kia-8/SPRO2_S.O.B/README.md

# SPRO2_S.O.B
This repository is the Solar Optimizing Blossom (S.O.B.) which is a flower-shaped, self sustaining security device. It uses dual-axis solar-tracking petals to maximize energy collection and powers a motion activated audio alarm.
