kia-8/SPRO2_S.O.B/Mechanical/Technical Drawing/kiarash_Assembly SOB final.pdf

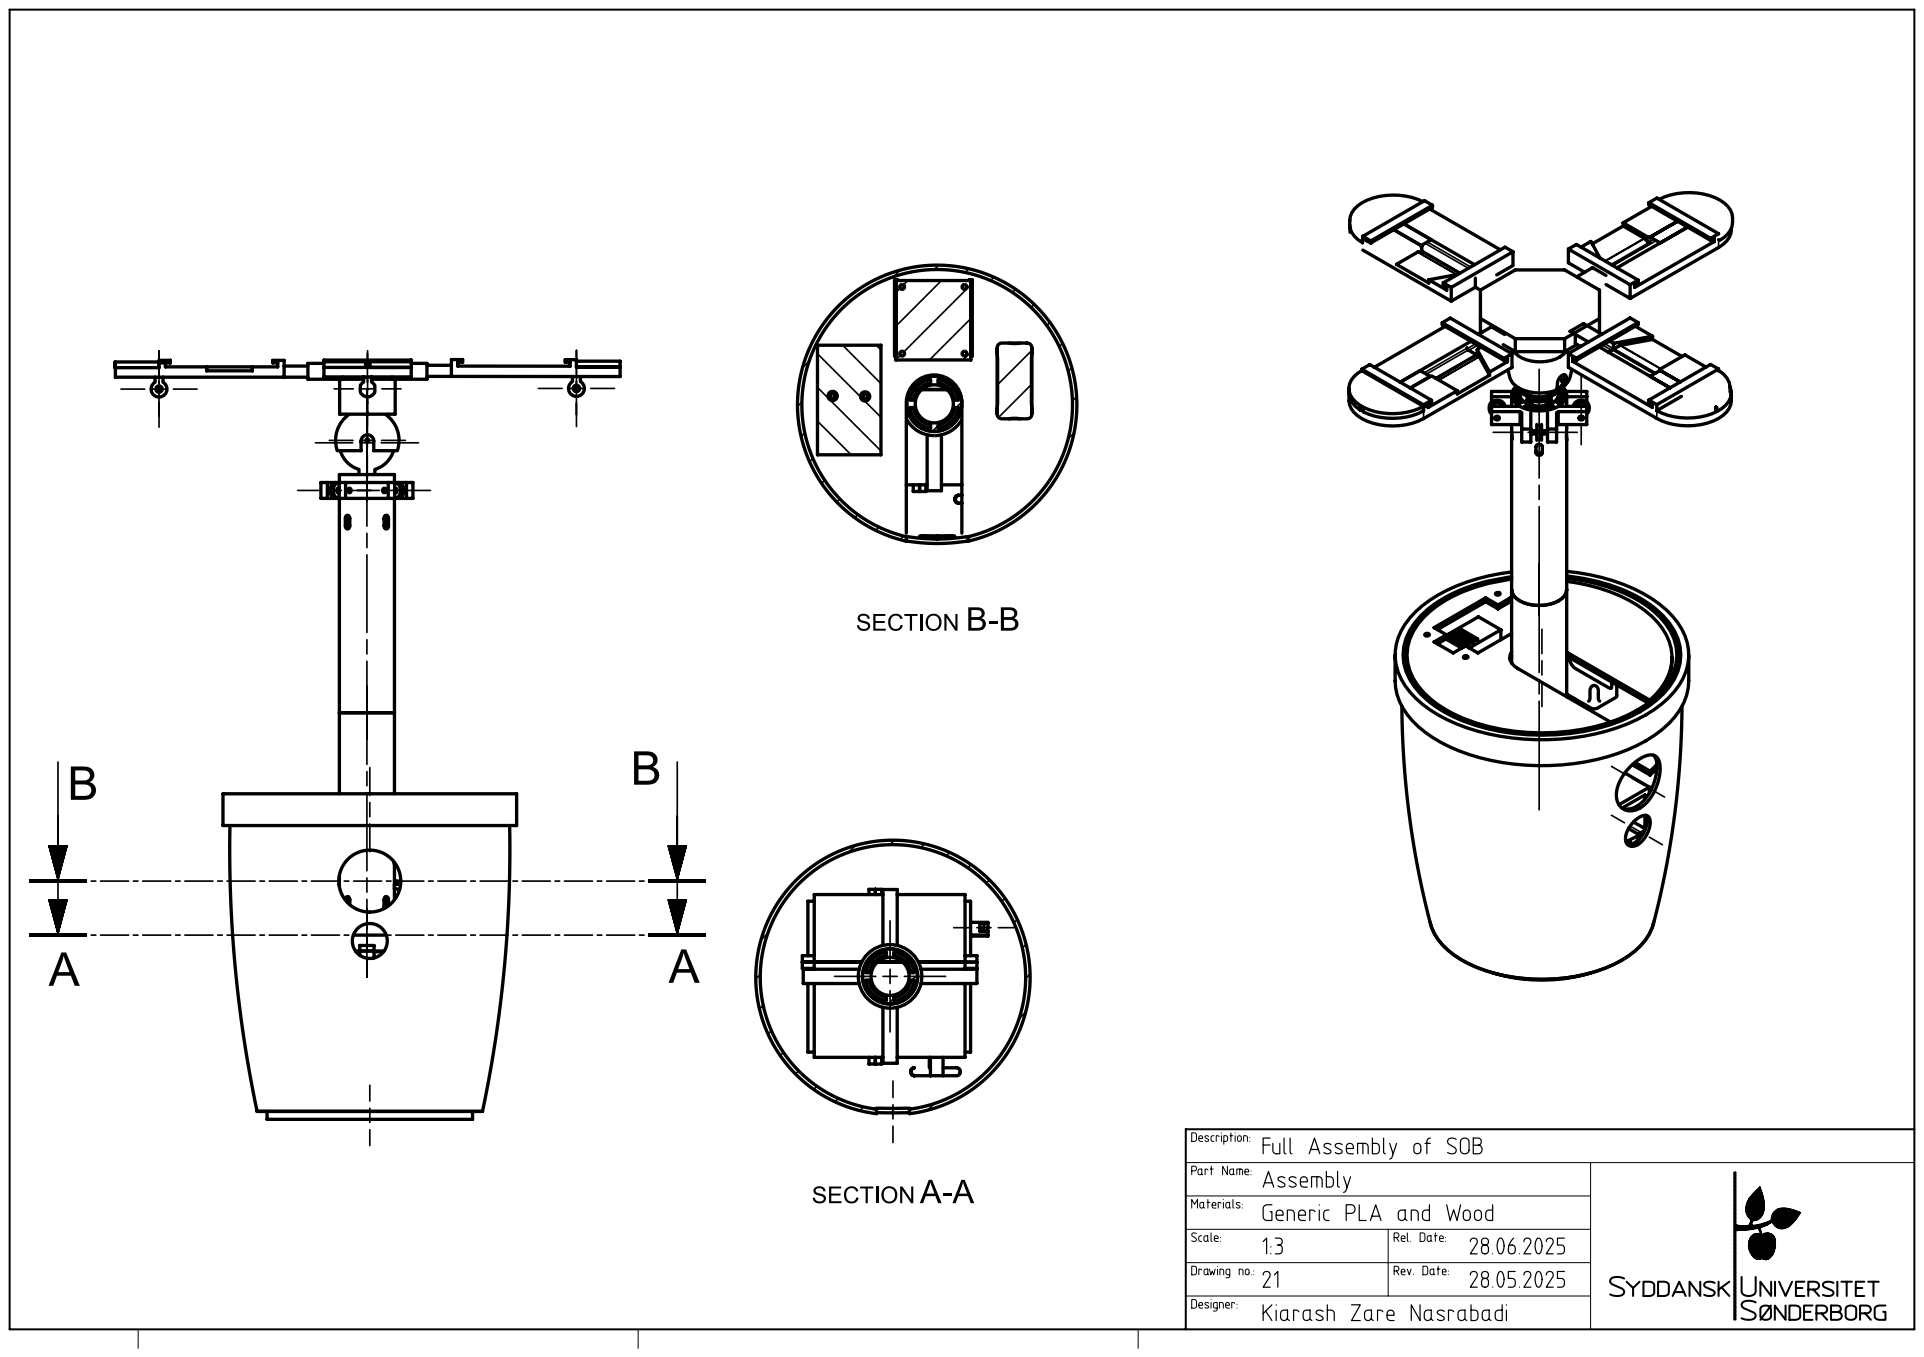
[picture p84: page 1]
