kia-8/SPRO2_S.O.B/Mechanical/Technical Drawing/kiarash_Battery holder.pdf

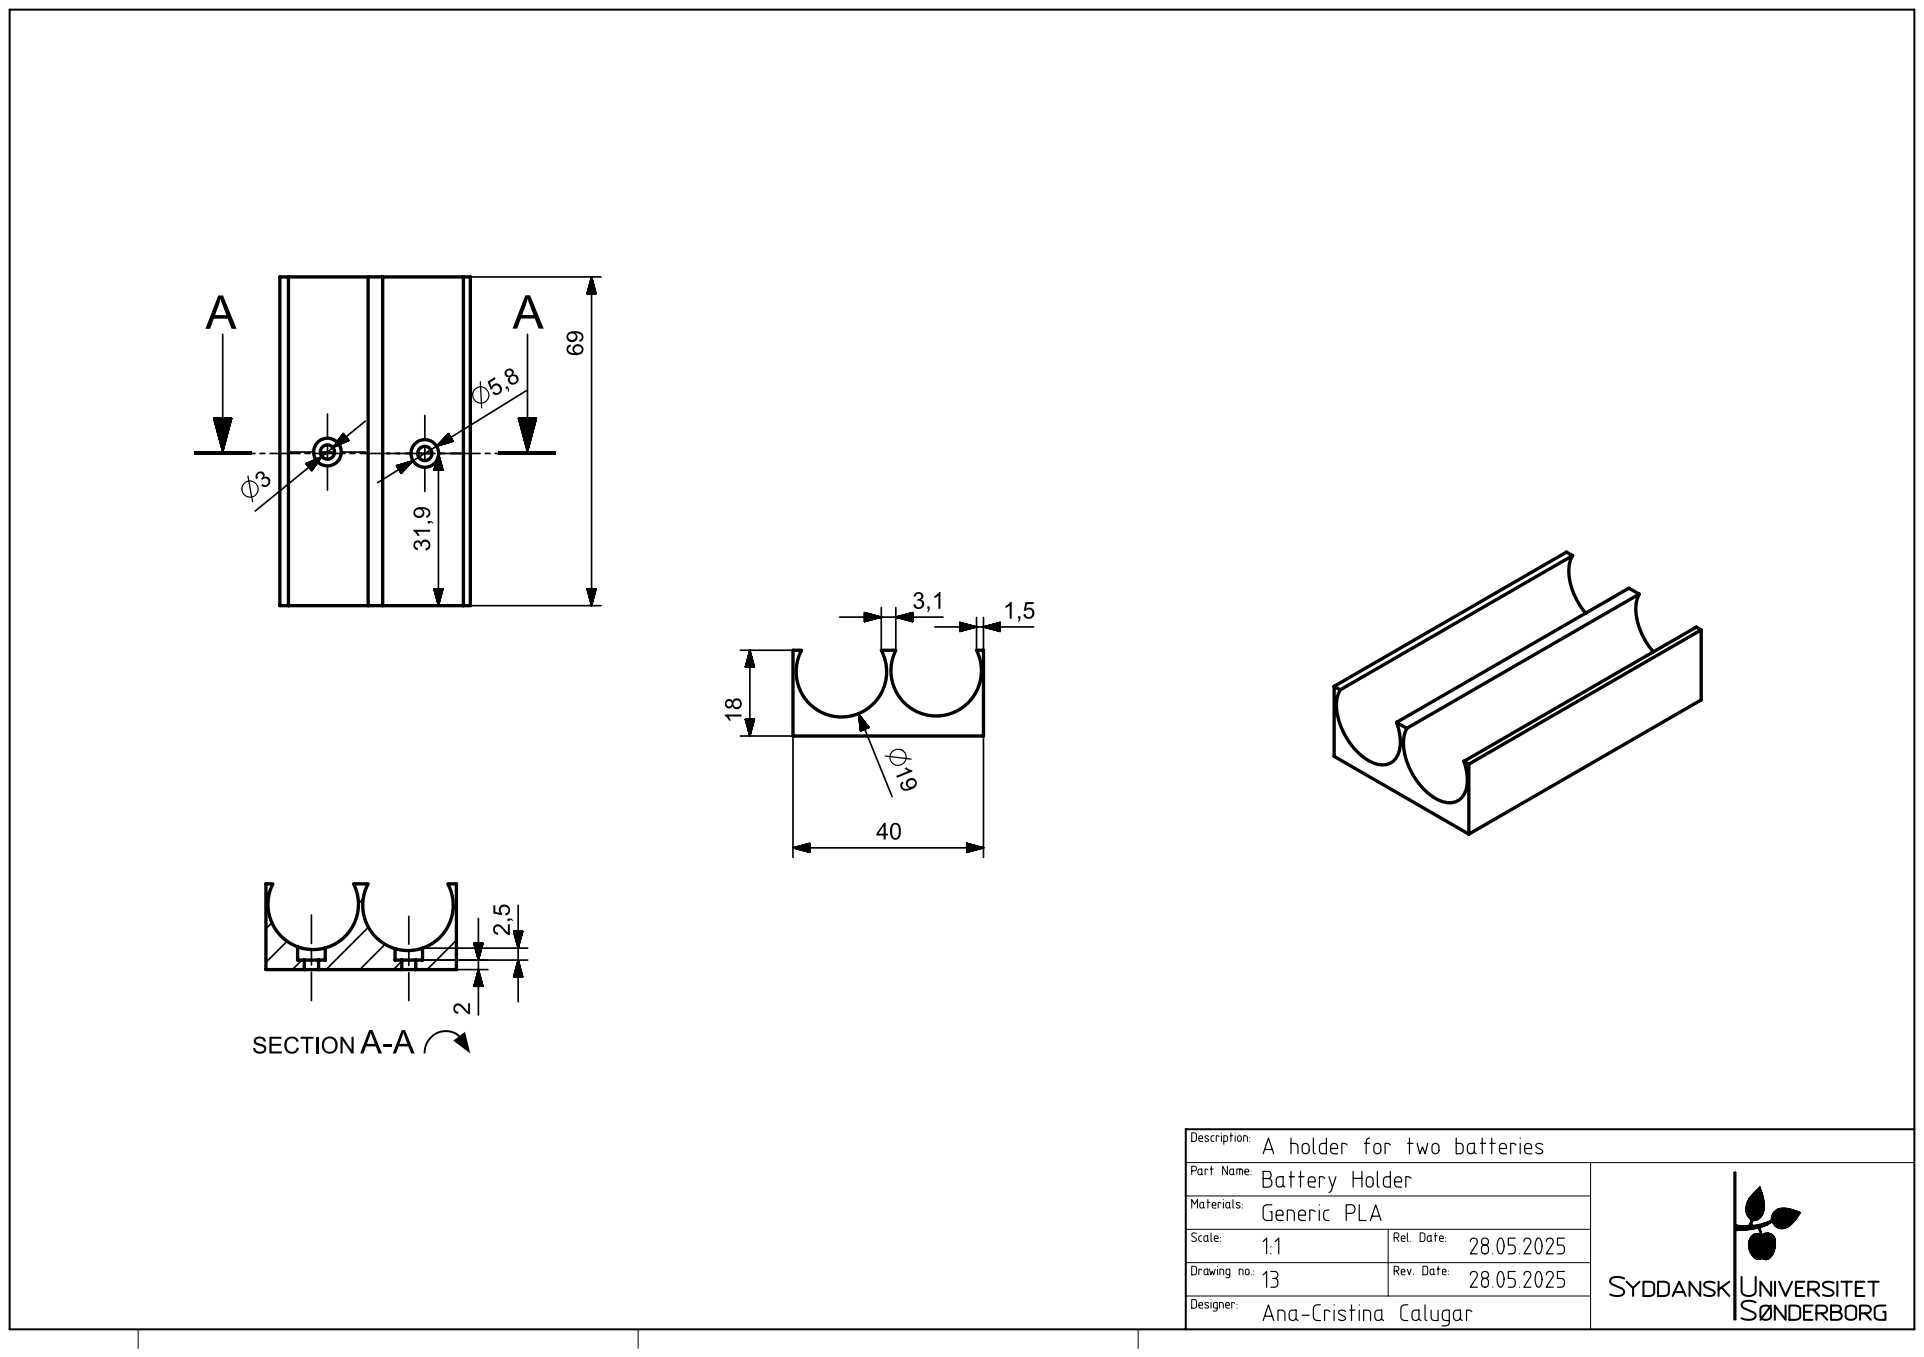
[picture p85: page 1]
