kia-8/SPRO2_S.O.B/Mechanical/Technical Drawing/kiarash_batteryholder2.pdf

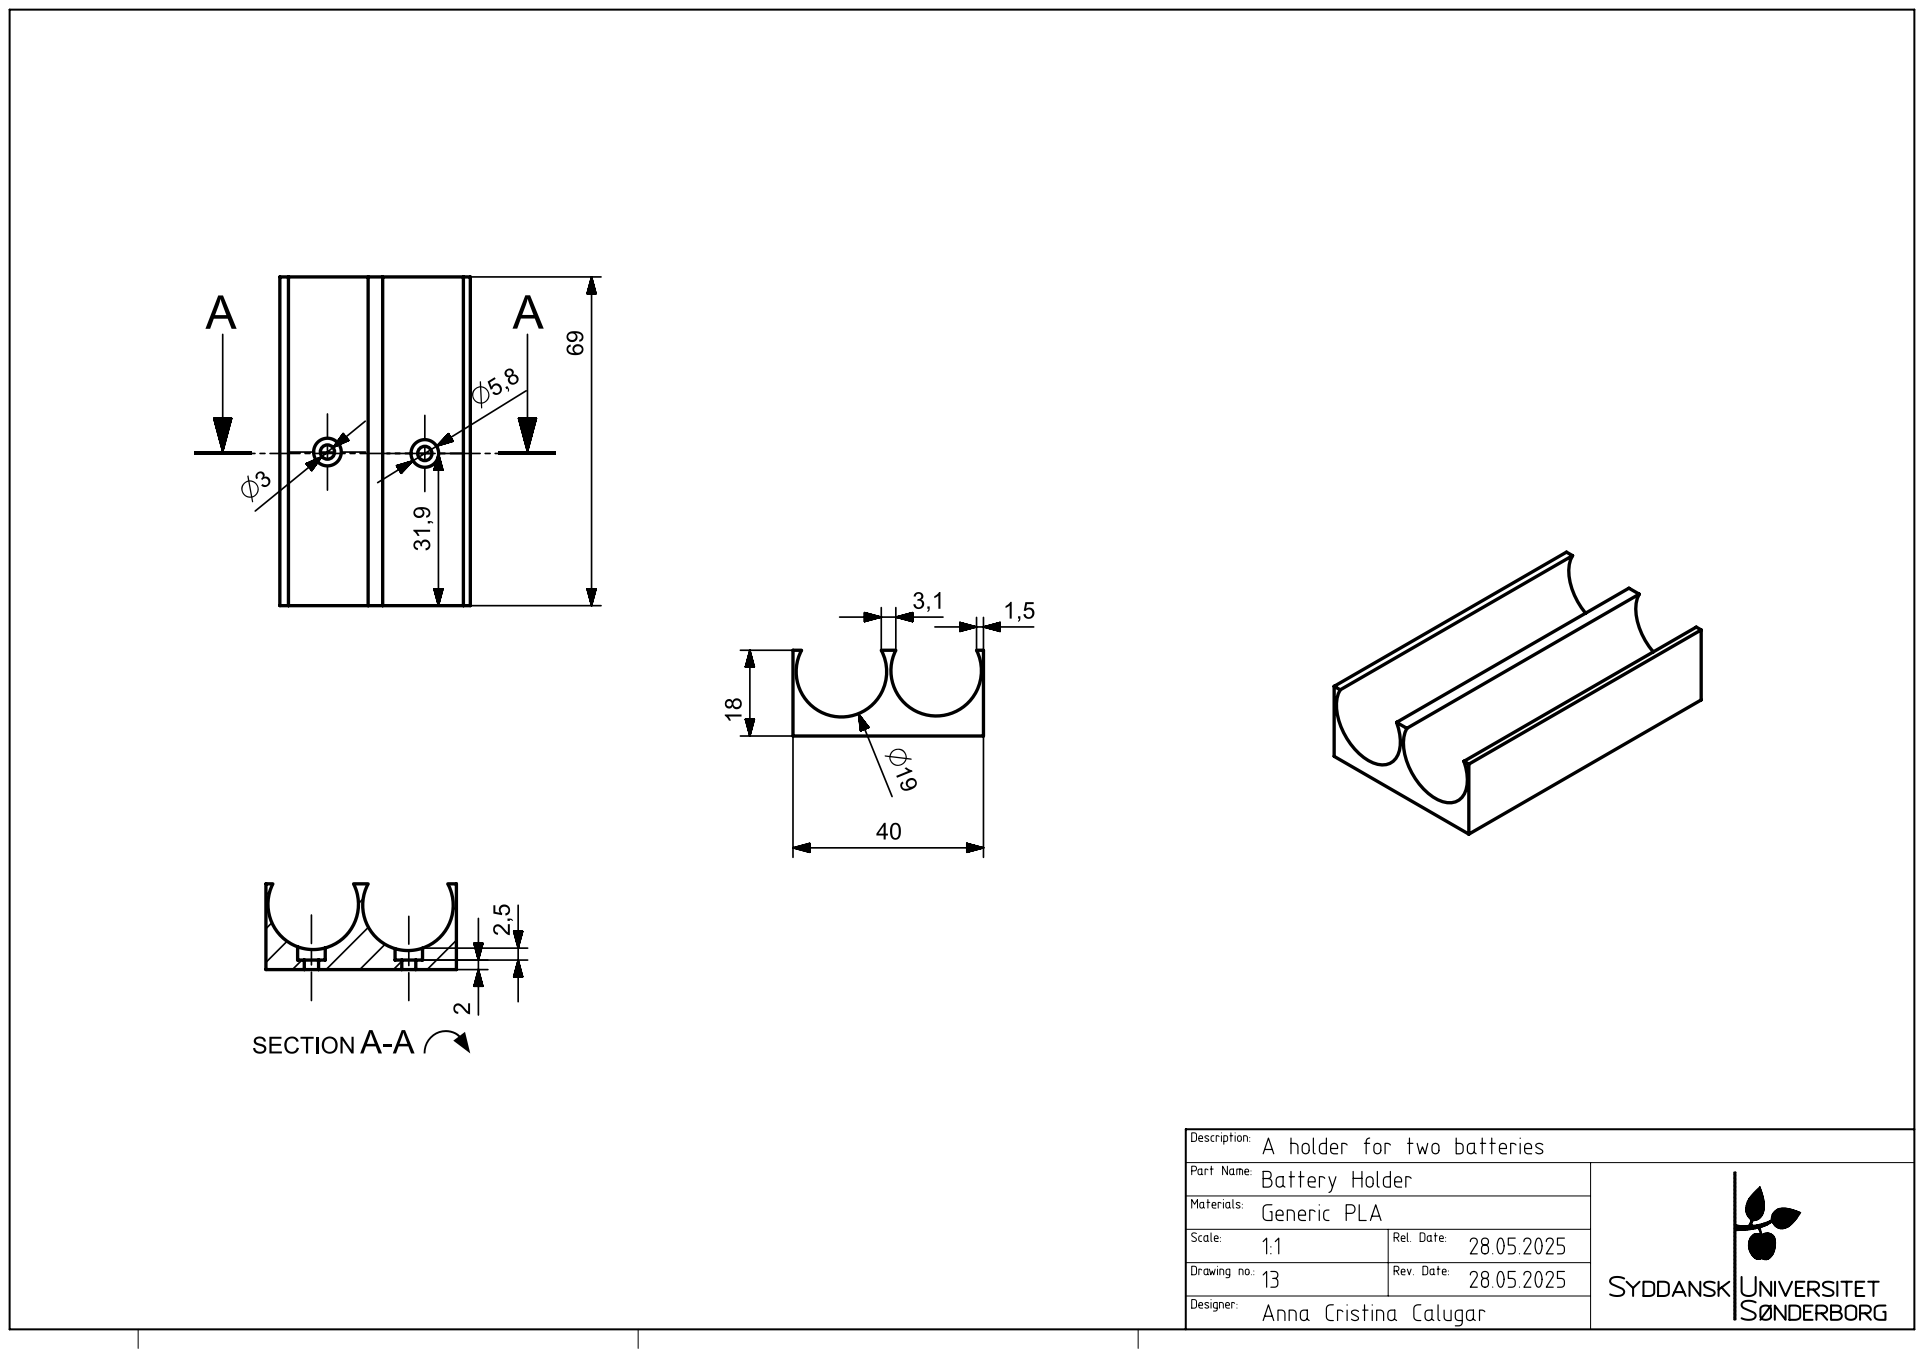
[picture p86: page 1]
