kia-8/SPRO2_S.O.B/Mechanical/Technical Drawing/kiarash_Cap of case for servo2.pdf

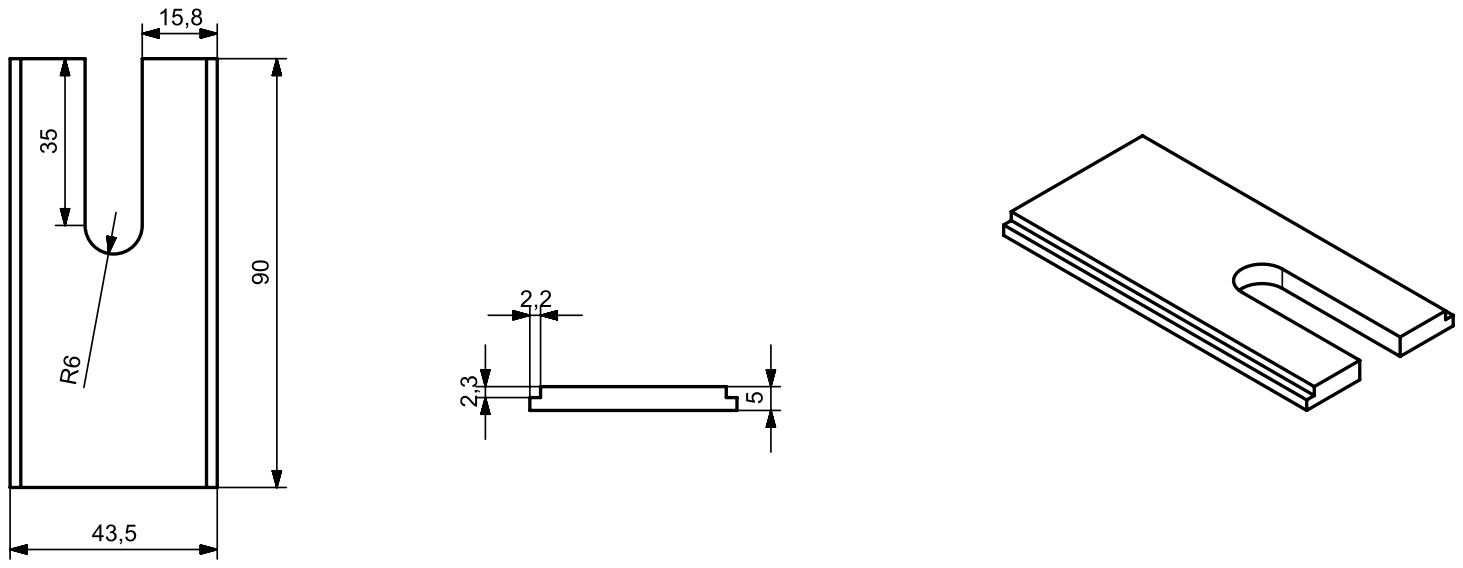
[picture p87: page 1]
