kia-8/SPRO2_S.O.B/Mechanical/Technical Drawing/kiarash_case for motor driver 2.2.pdf

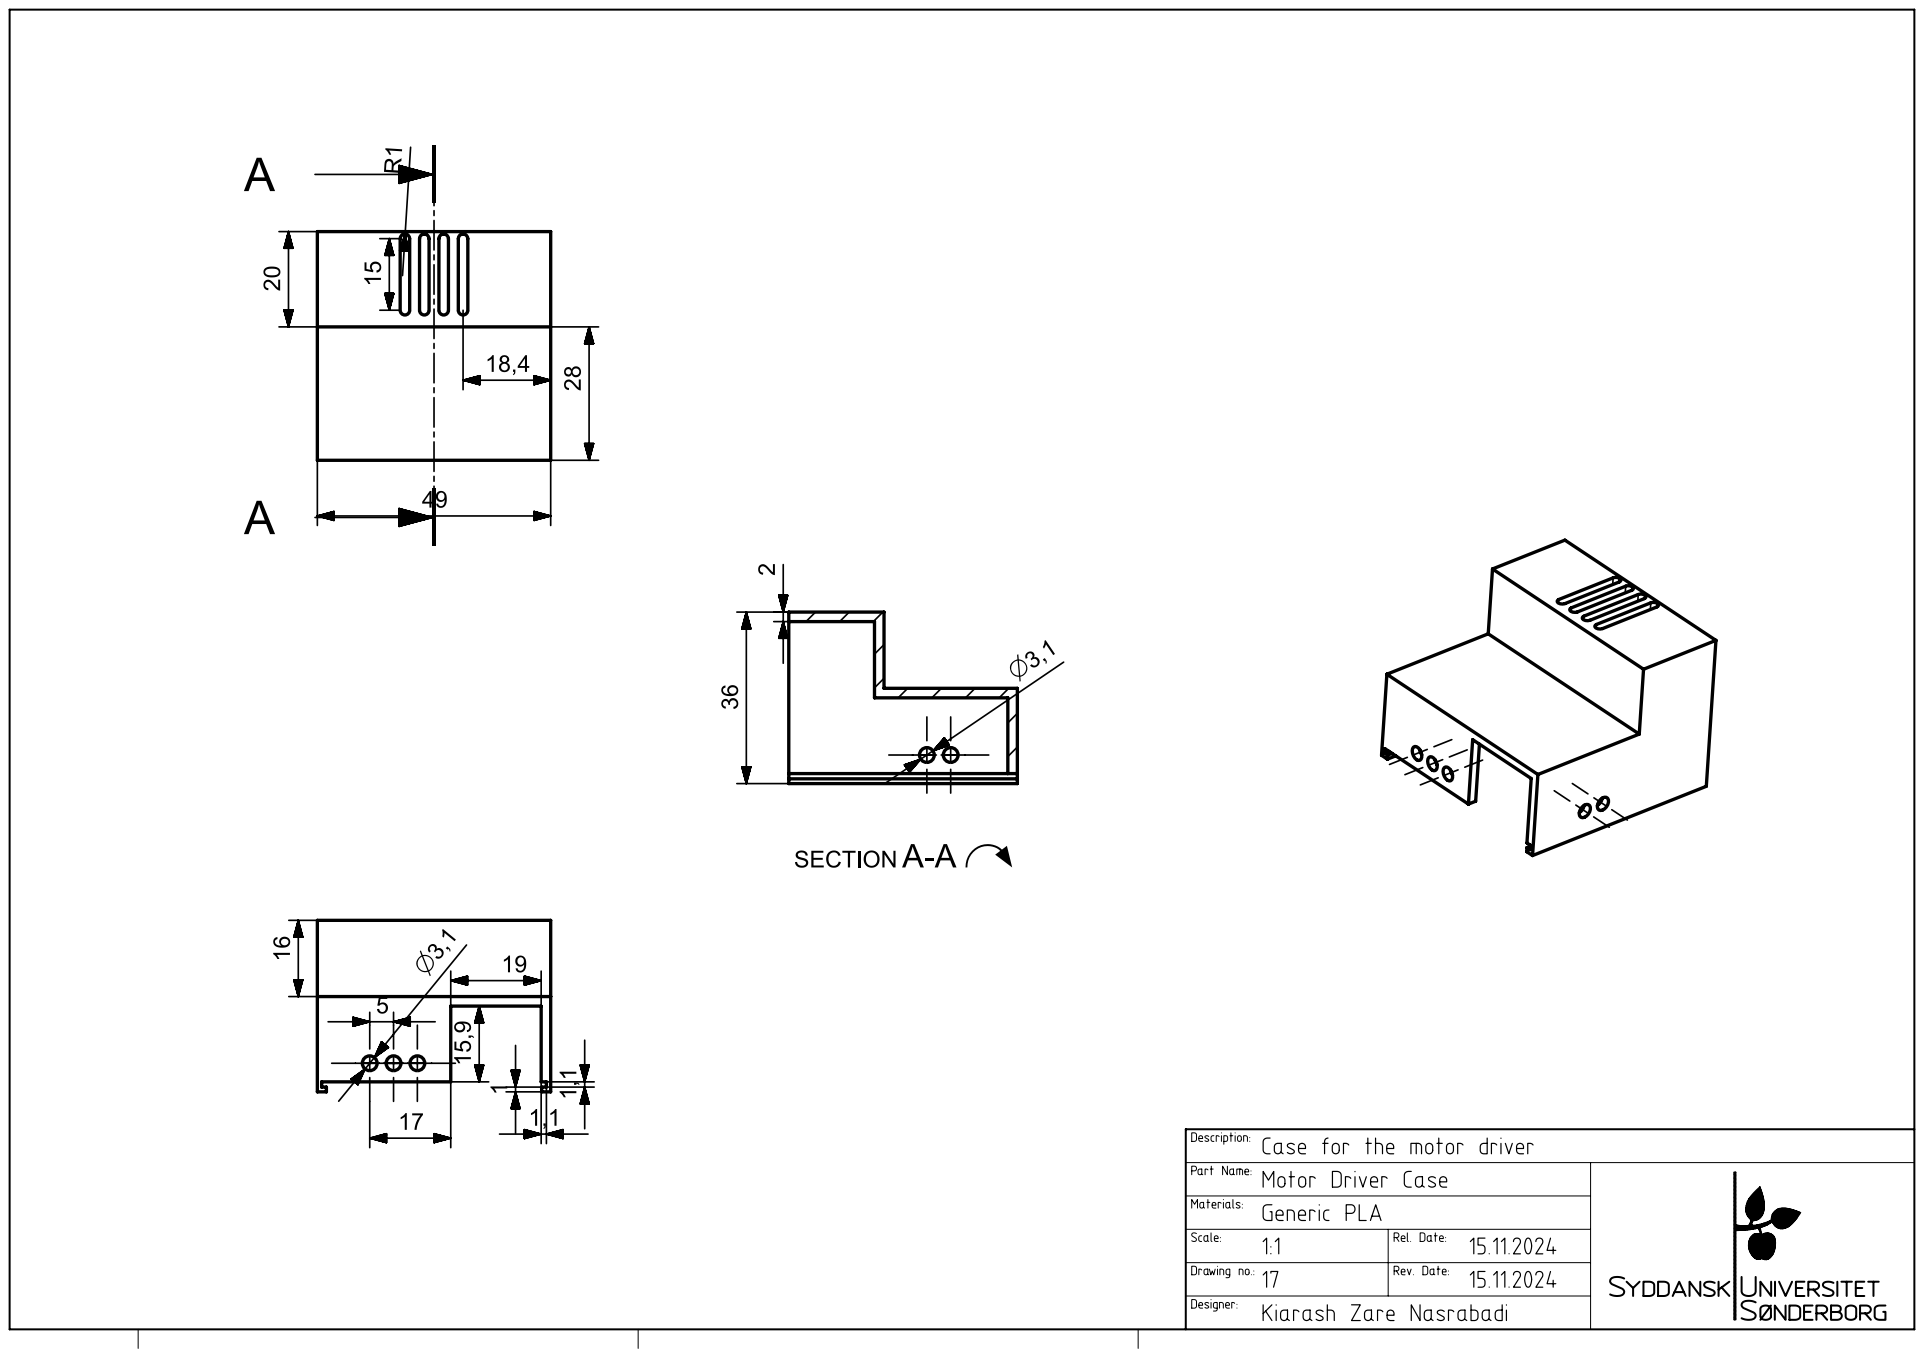
[picture p88: page 1]
