kia-8/SPRO2_S.O.B/Mechanical/Technical Drawing/kiarash_Case toop part final.pdf

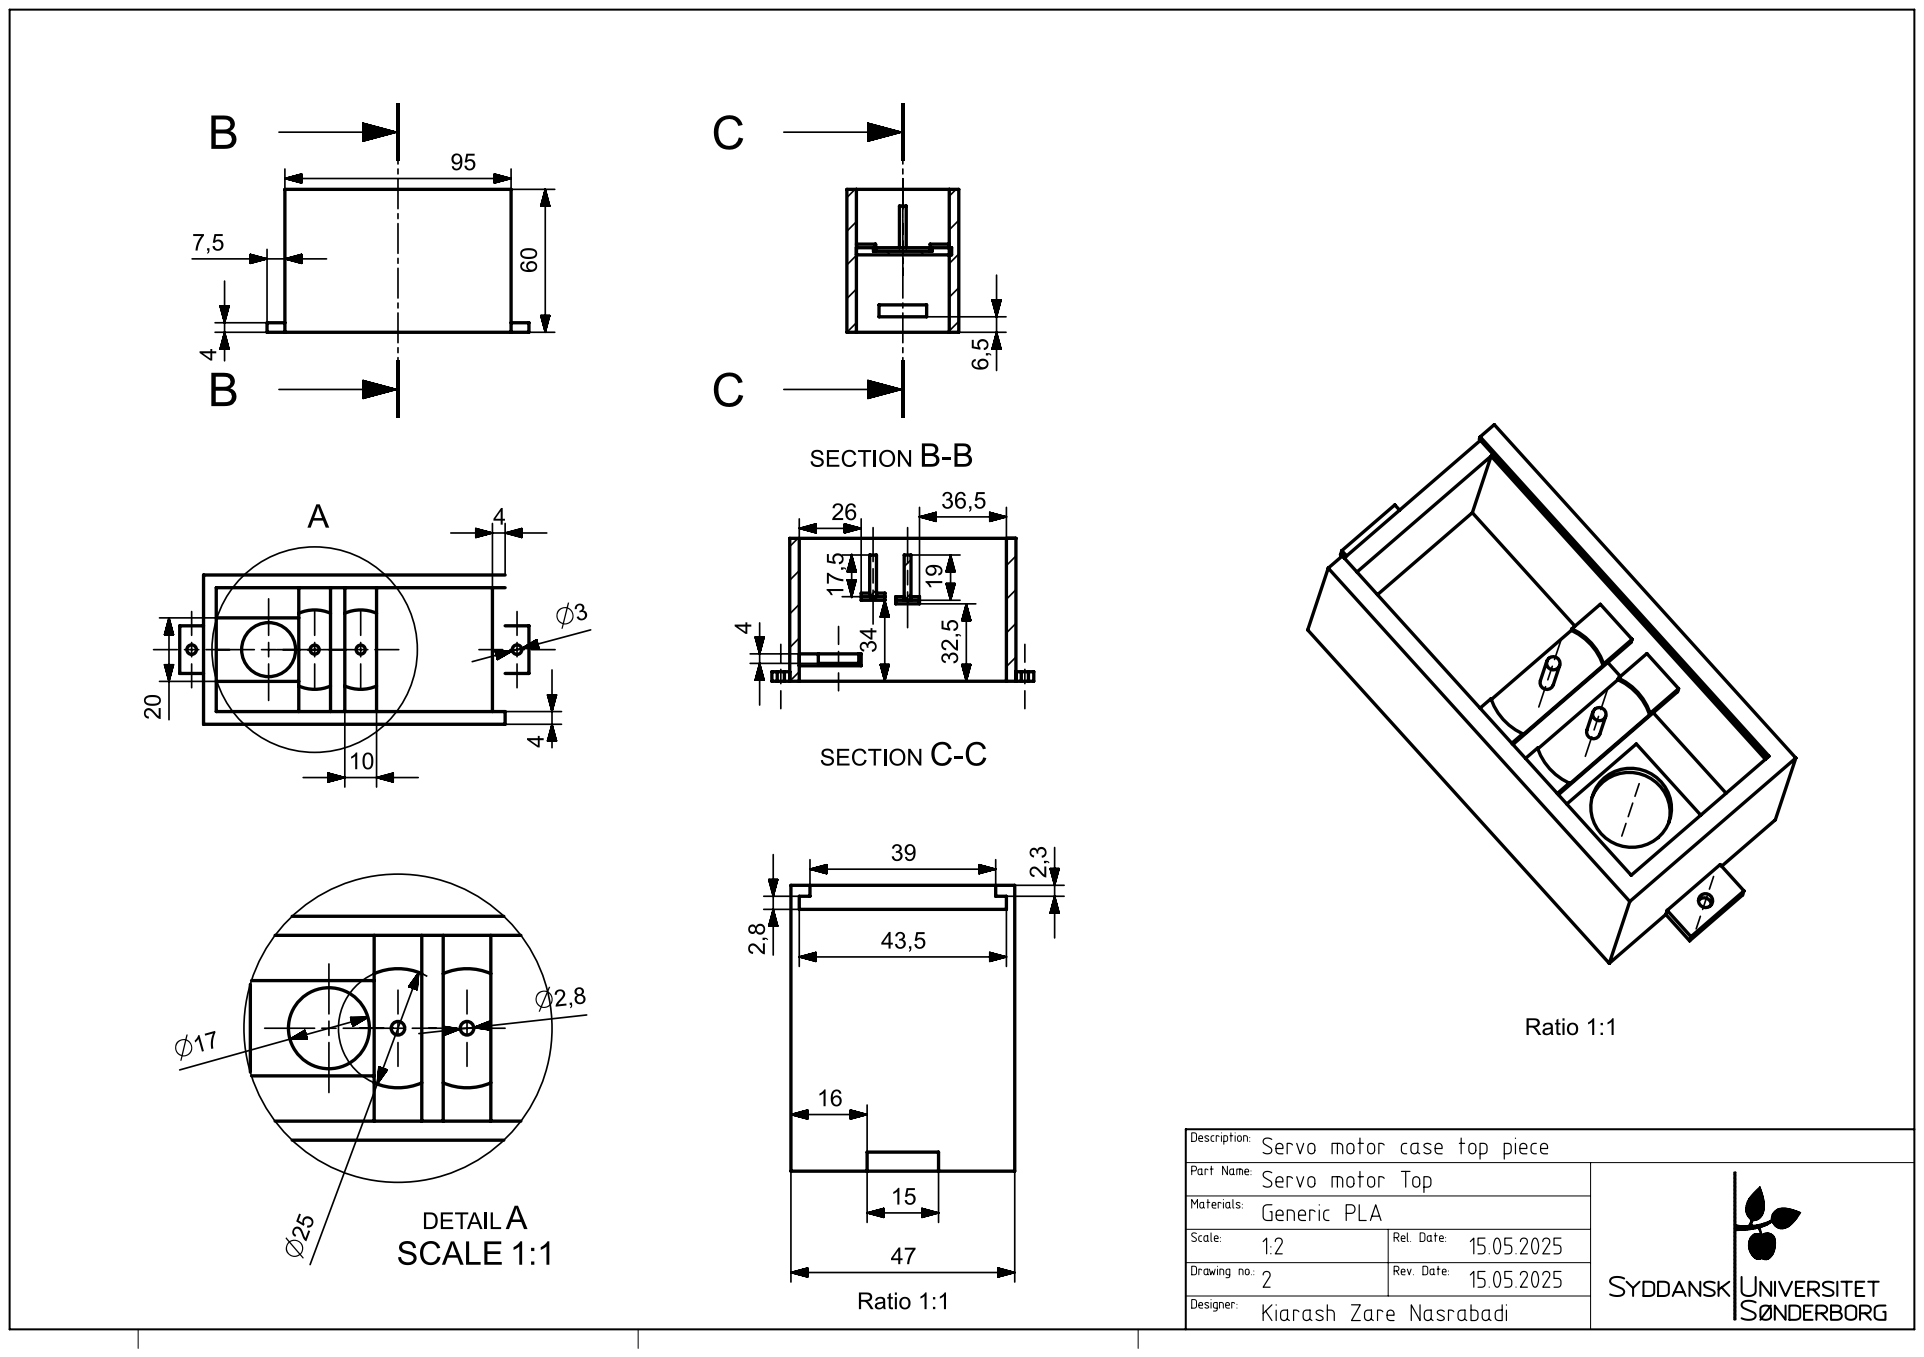
[picture p89: page 1]
