kia-8/SPRO2_S.O.B/Mechanical/Technical Drawing/kiarash_Case top part final.pdf

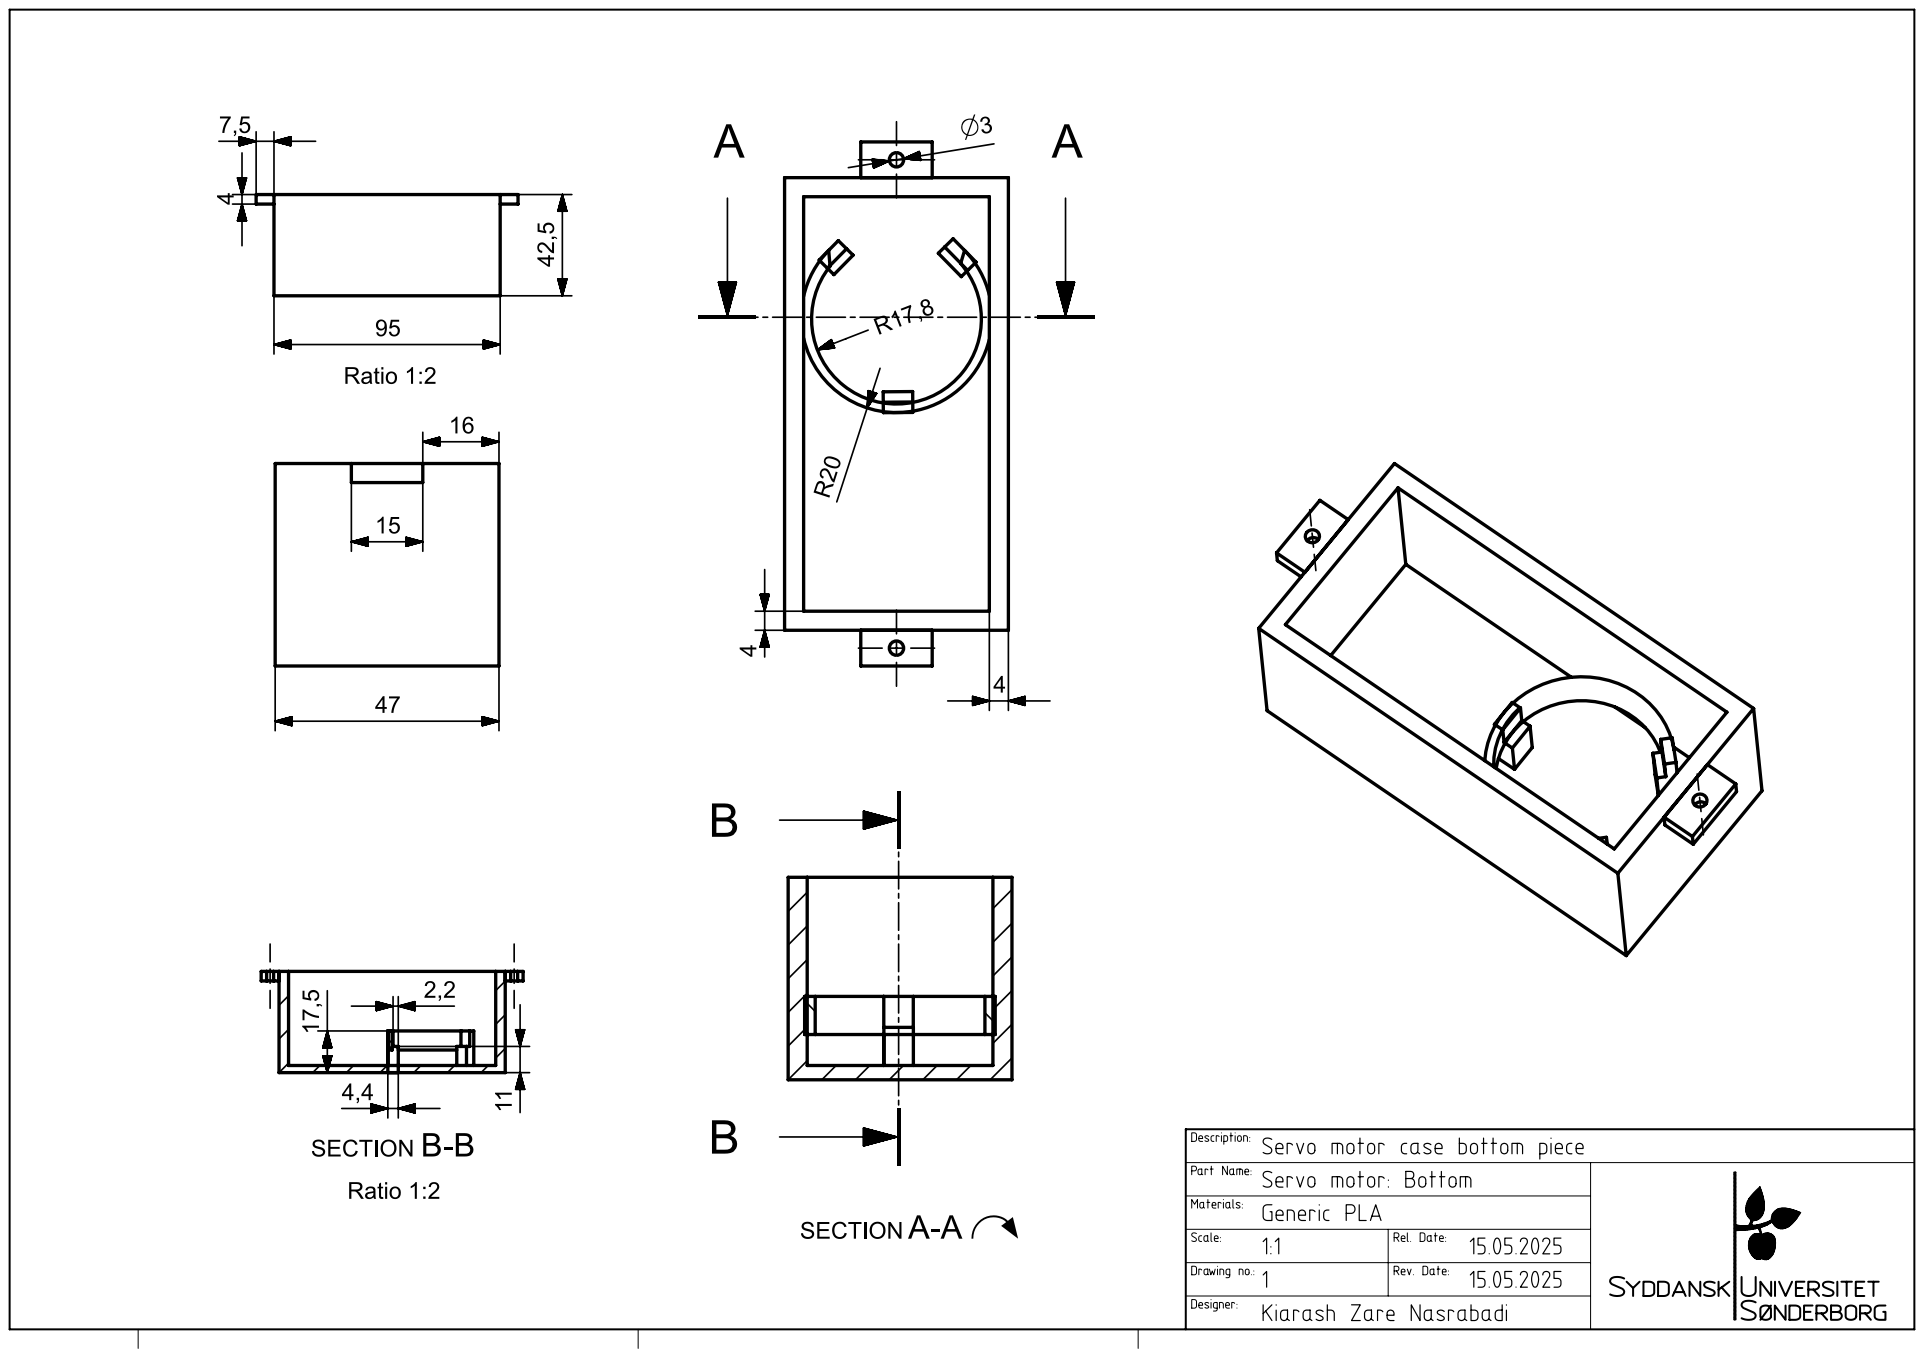
[picture p90: page 1]
