kia-8/SPRO2_S.O.B/Mechanical/Technical Drawing/kiarash_Exploded View SOBl.pdf

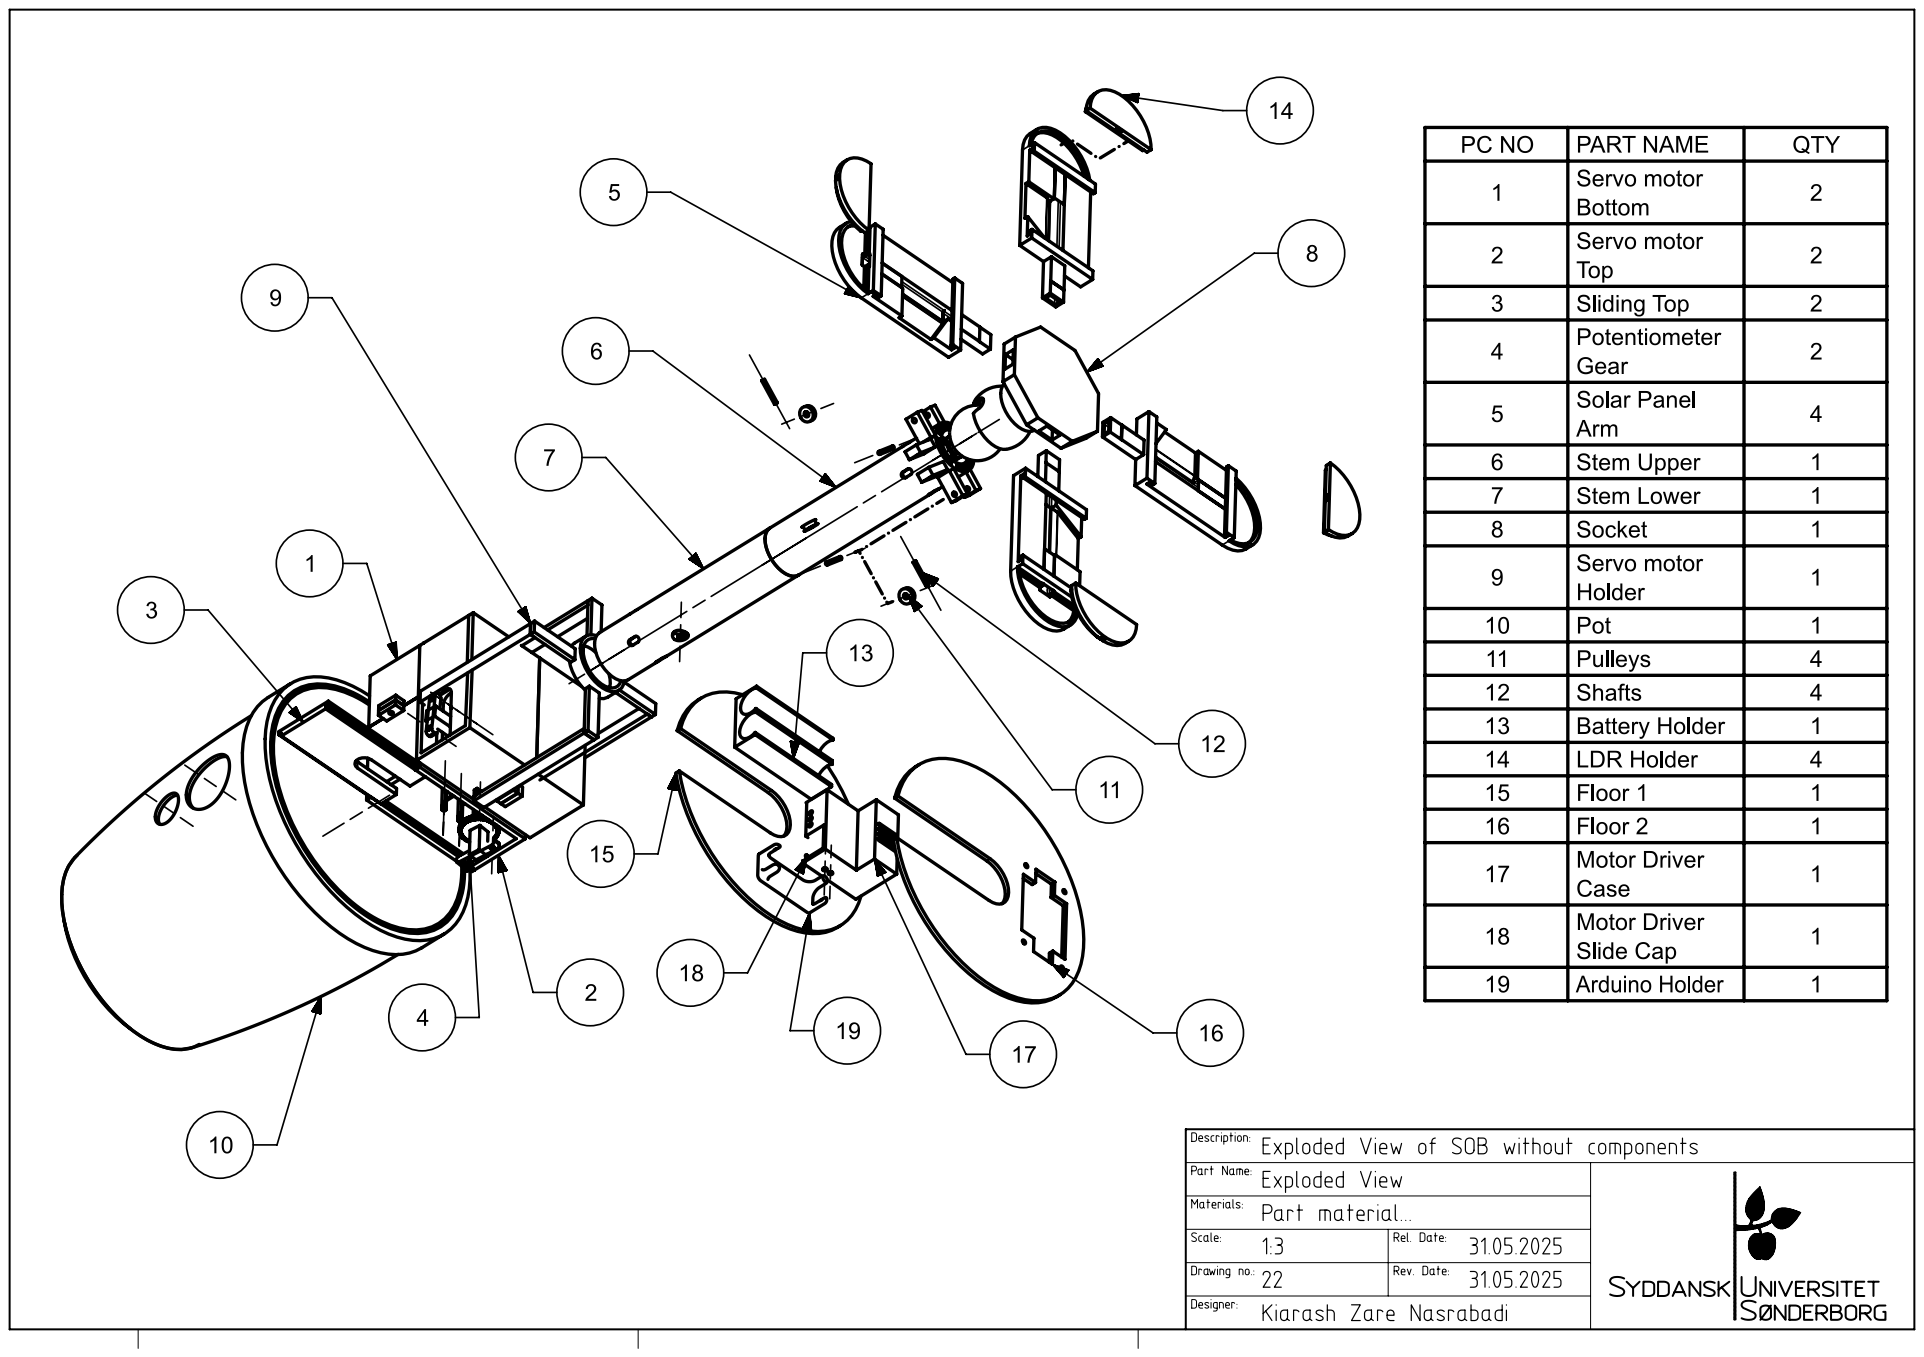
[picture p91: page 1]
