kia-8/SPRO2_S.O.B/Mechanical/Technical Drawing/kiarash_Exploded View.pdf

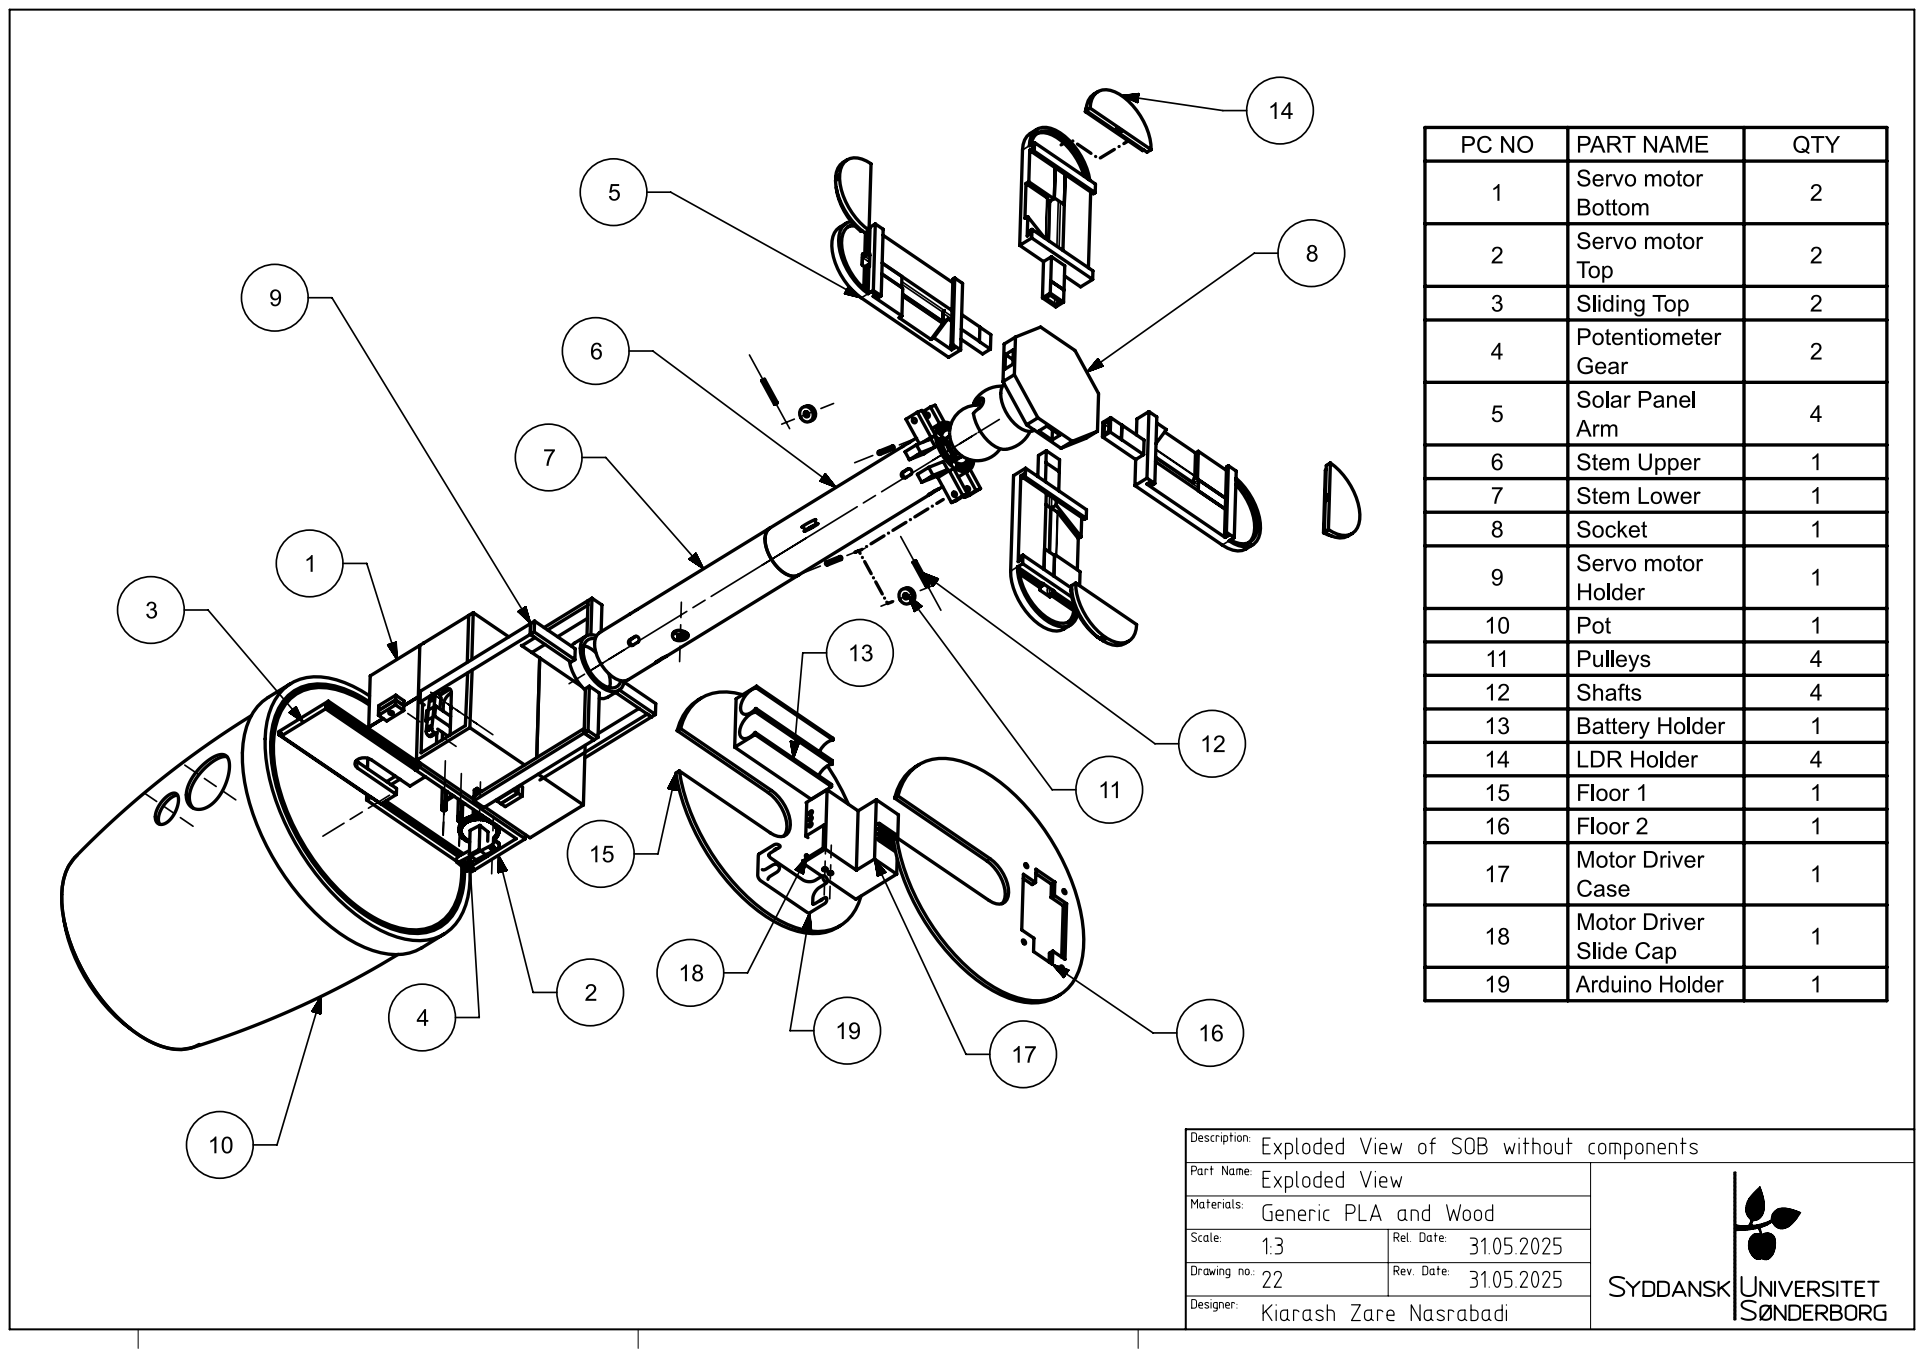
[picture p92: page 1]
