kia-8/SPRO2_S.O.B/Mechanical/Technical Drawing/kiarash_floor 1 final.pdf

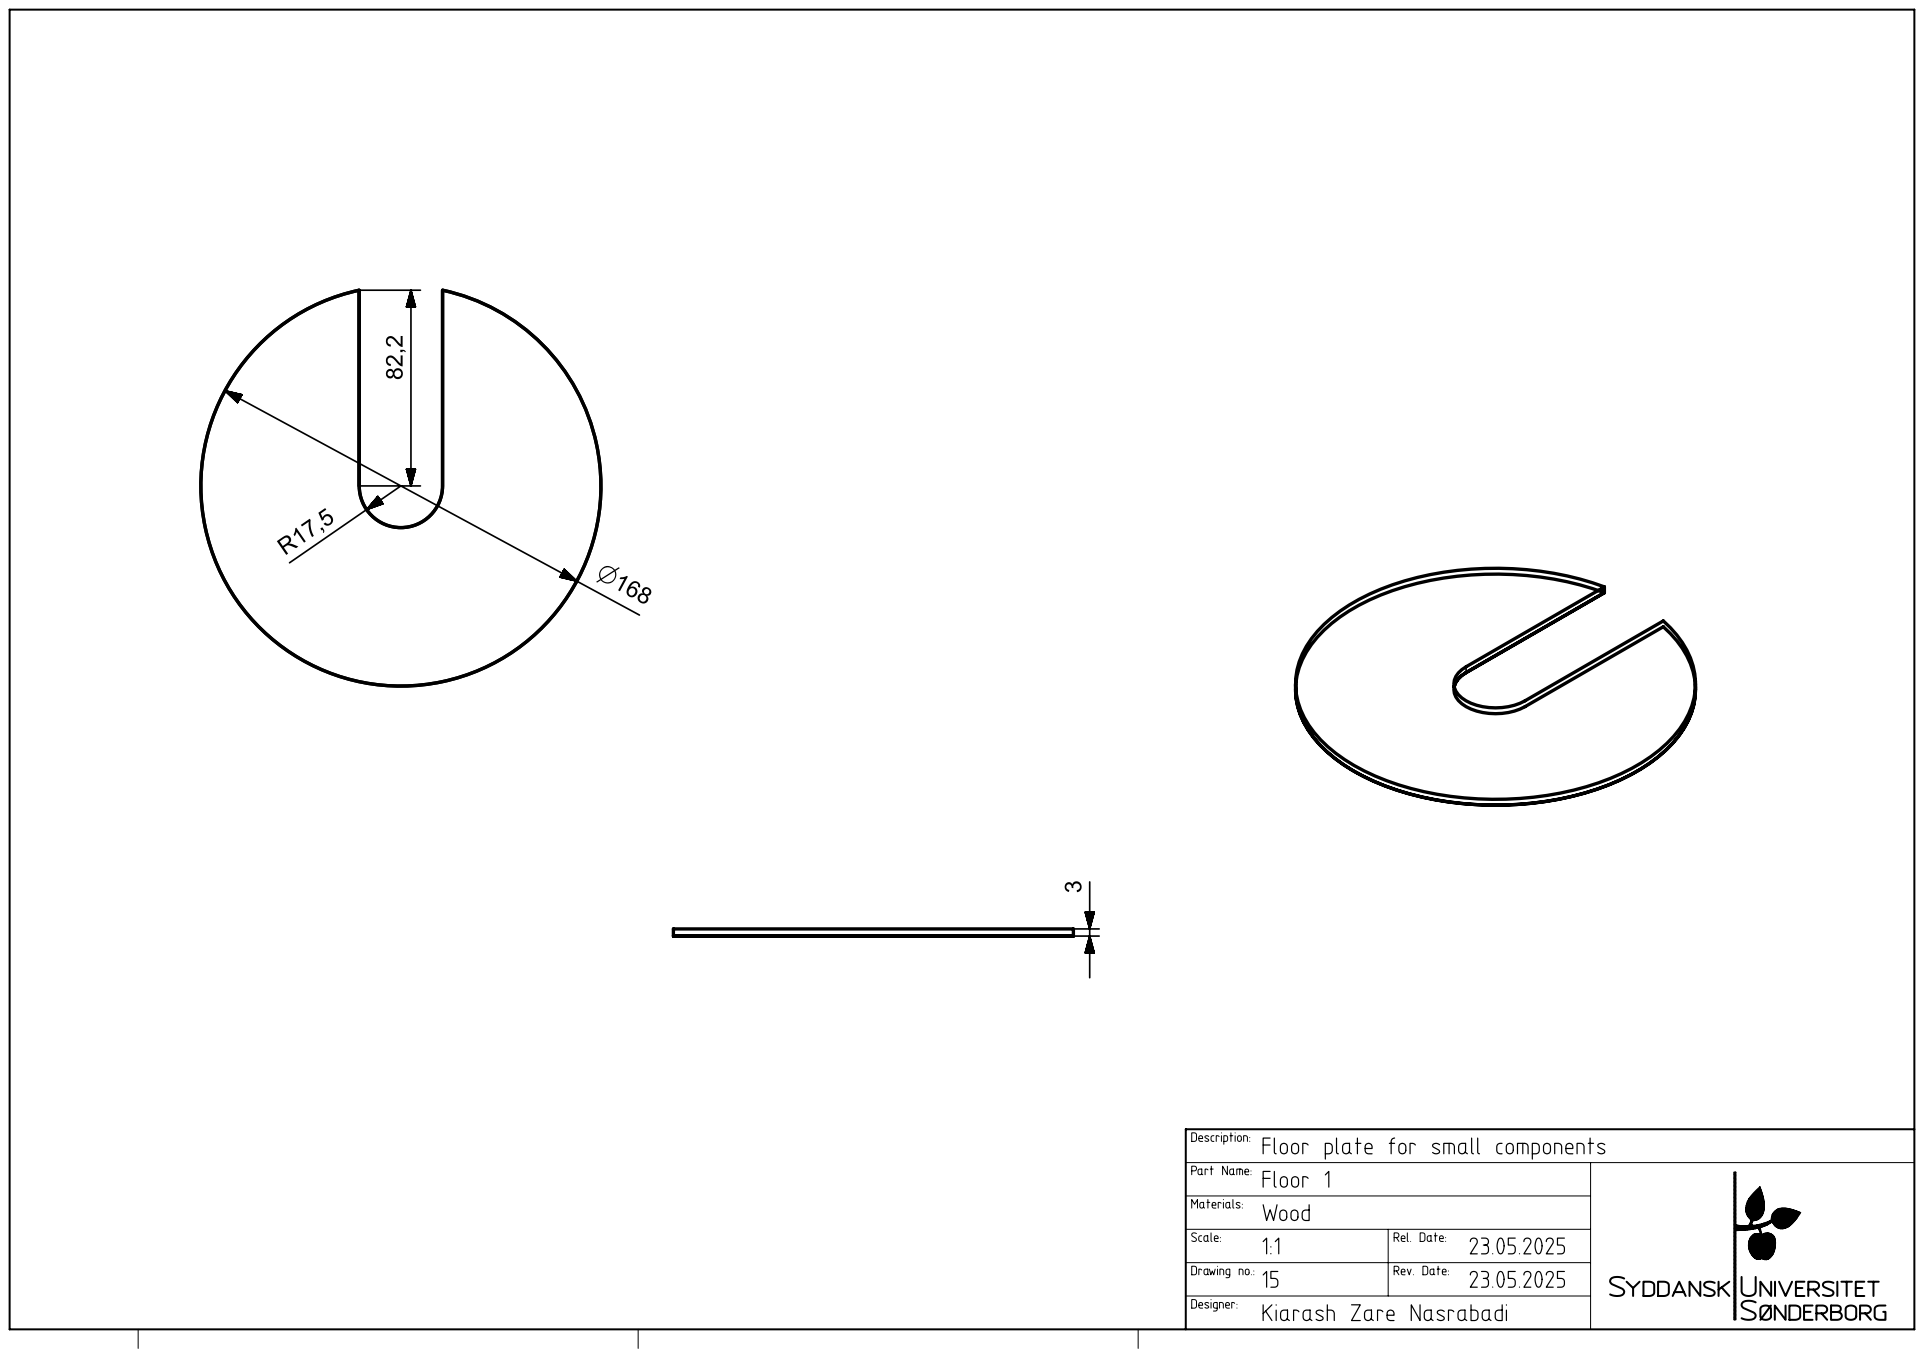
[picture p93: page 1]
