kia-8/SPRO2_S.O.B/Mechanical/Technical Drawing/kiarash_Floor 2.pdf

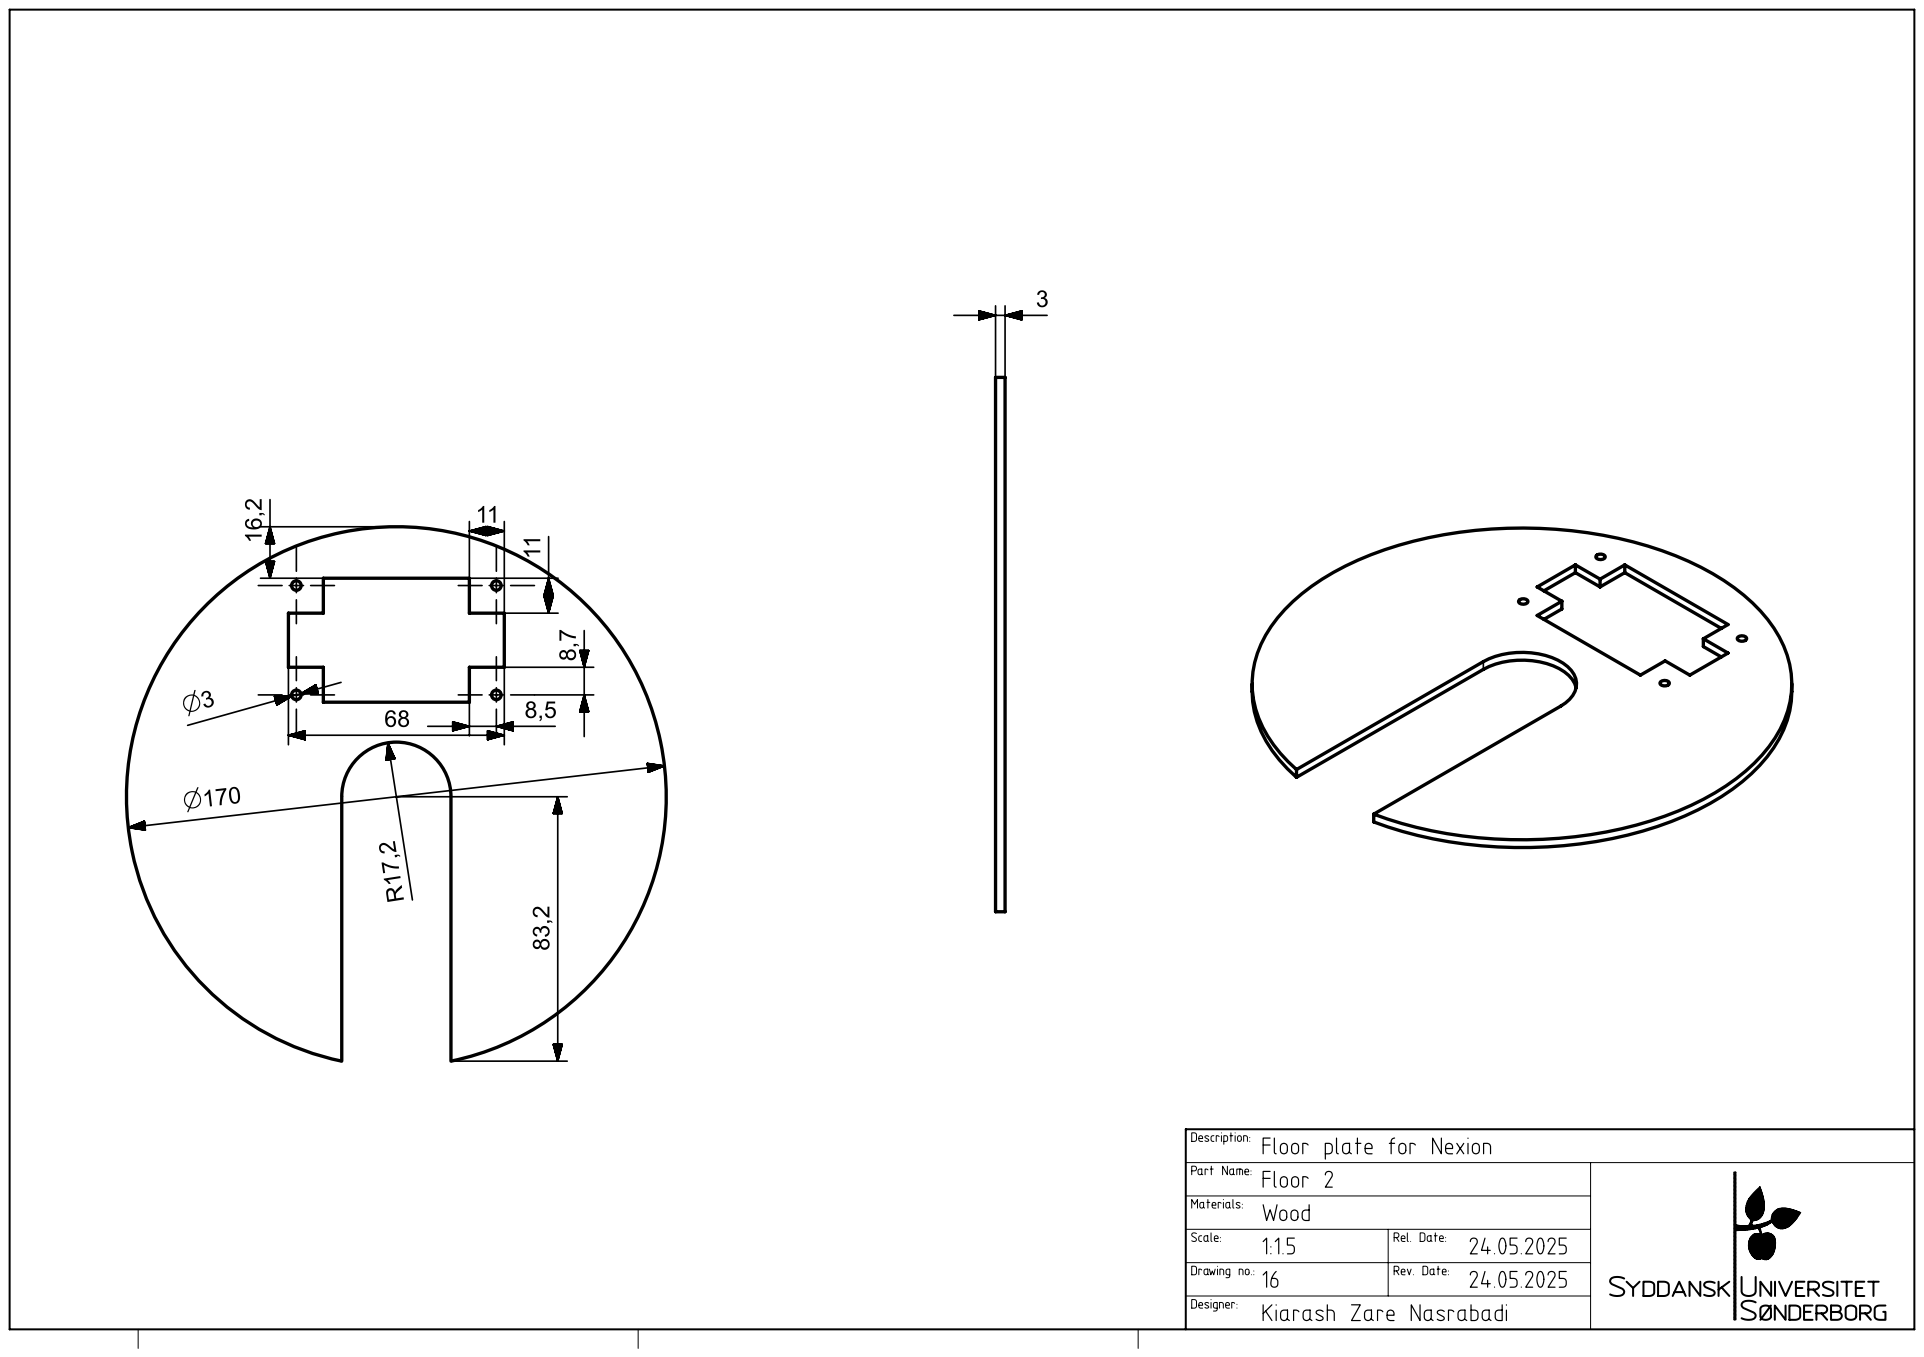
[picture p94: page 1]
