kia-8/SPRO2_S.O.B/Mechanical/Technical Drawing/kiarash_Gear potentiometer.pdf

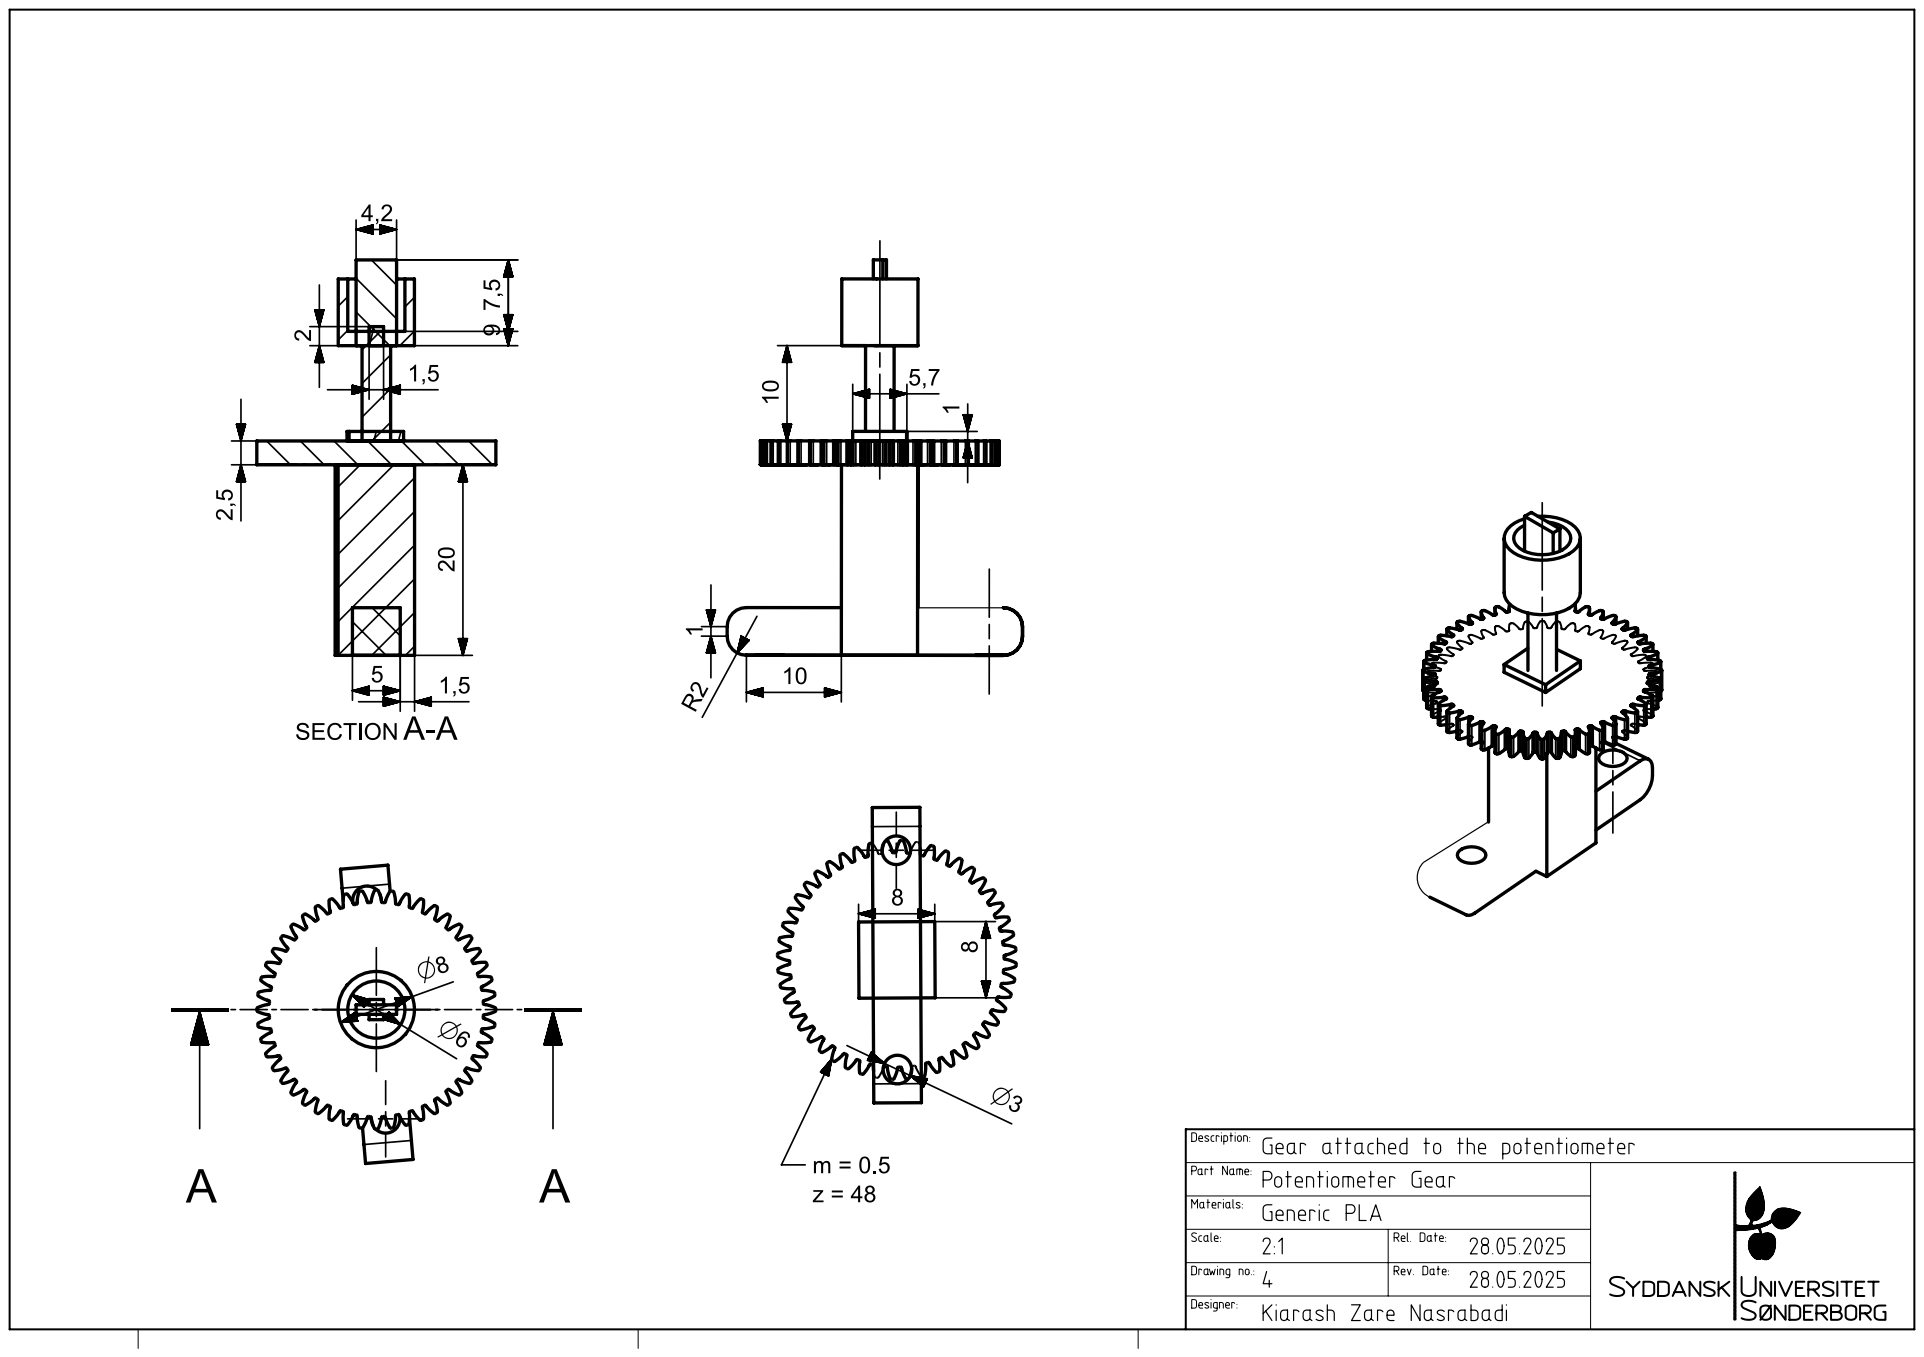
[picture p95: page 1]
