kia-8/SPRO2_S.O.B/Mechanical/Technical Drawing/kiarash_Motor driver plate.pdf

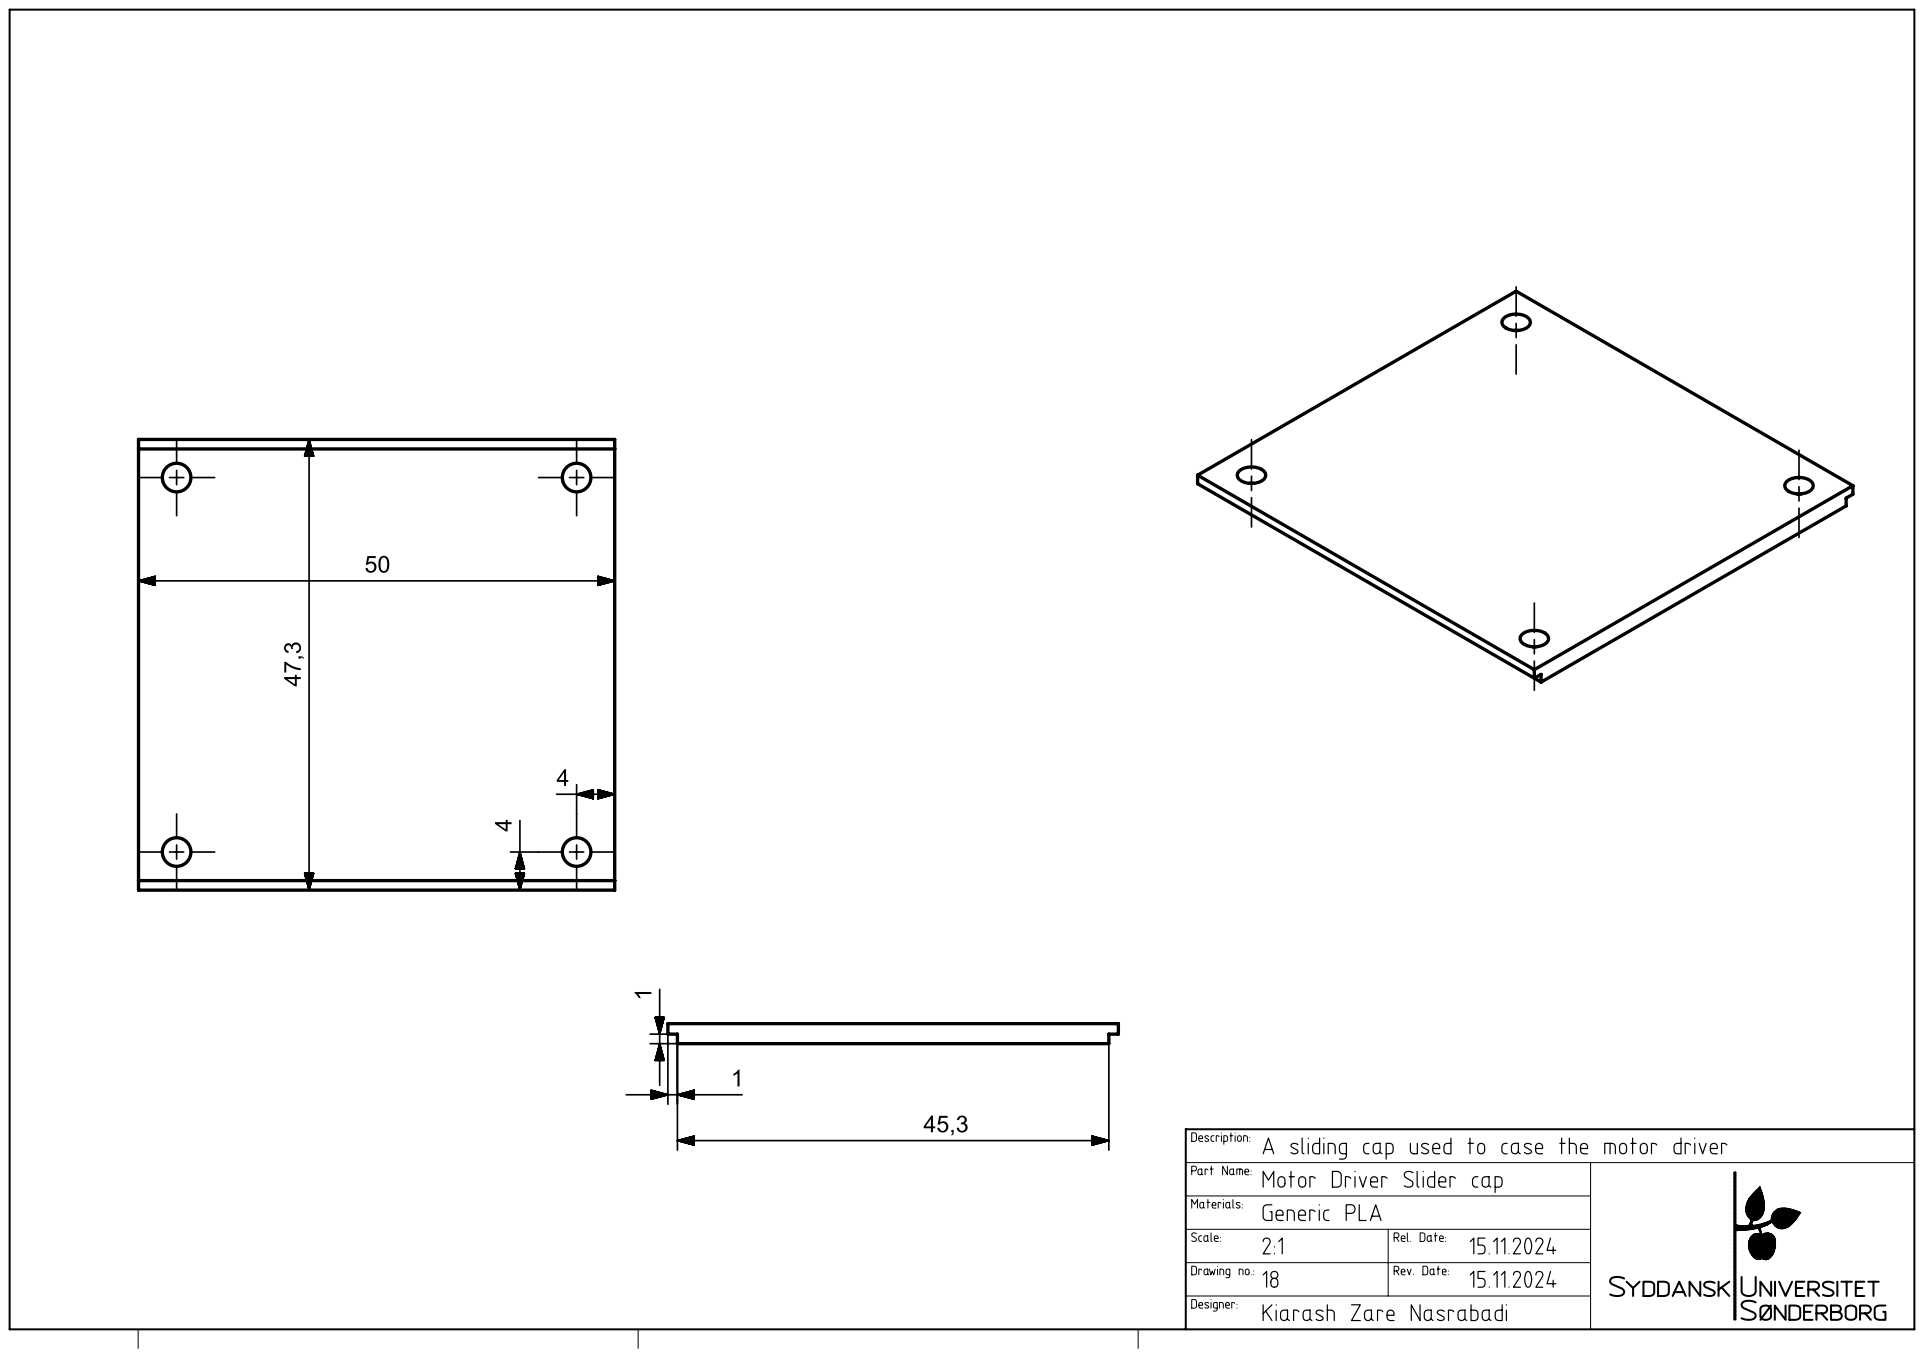
[picture p96: page 1]
