kia-8/SPRO2_S.O.B/Mechanical/Technical Drawing/kiarash_Motor gear final.pdf

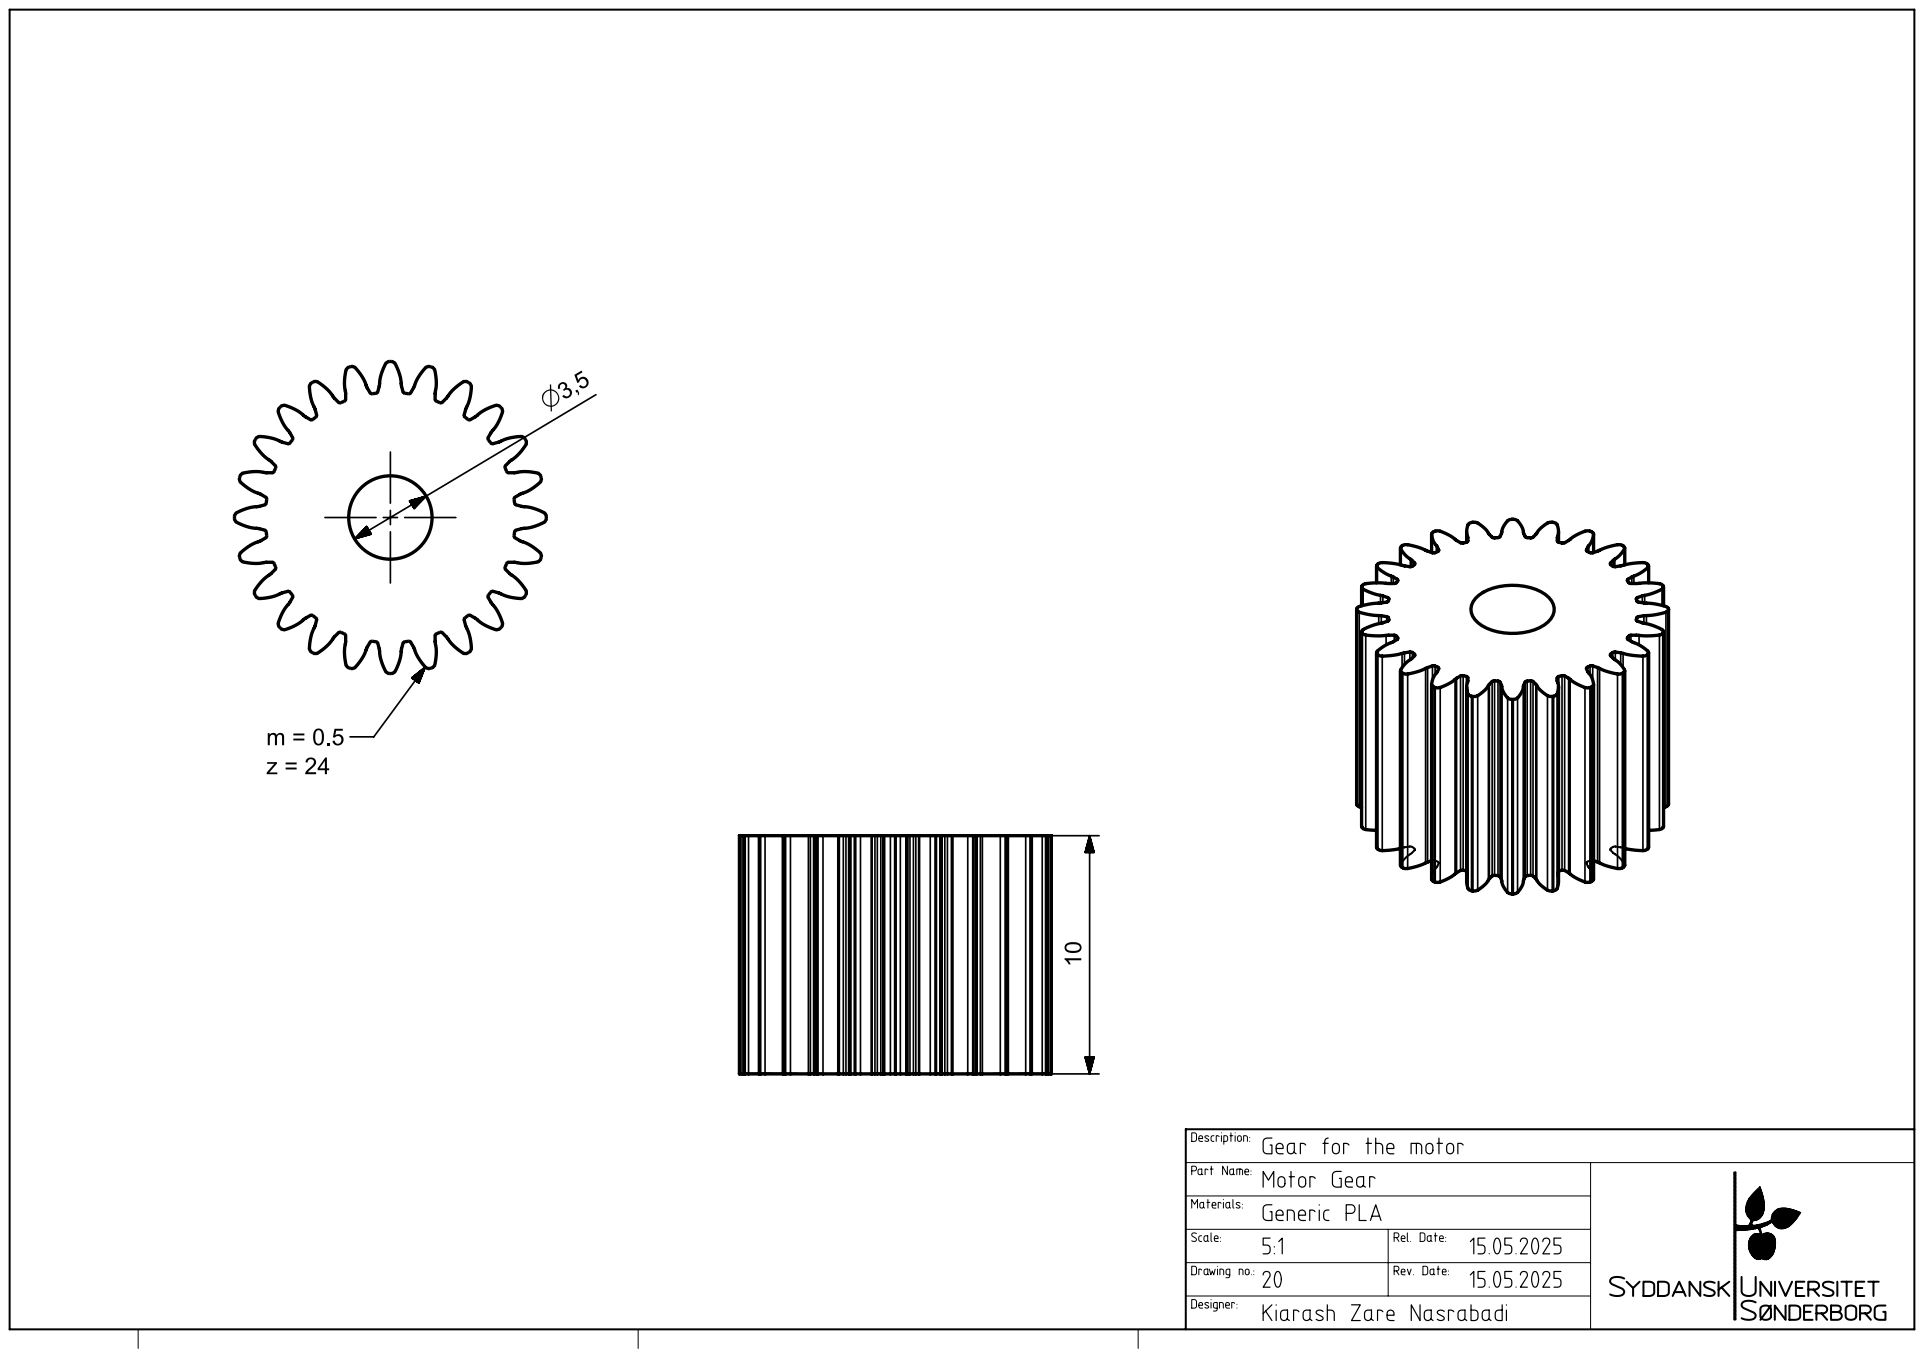
[picture p97: page 1]
