kia-8/SPRO2_S.O.B/Mechanical/Technical Drawing/kiarash_POT final.pdf

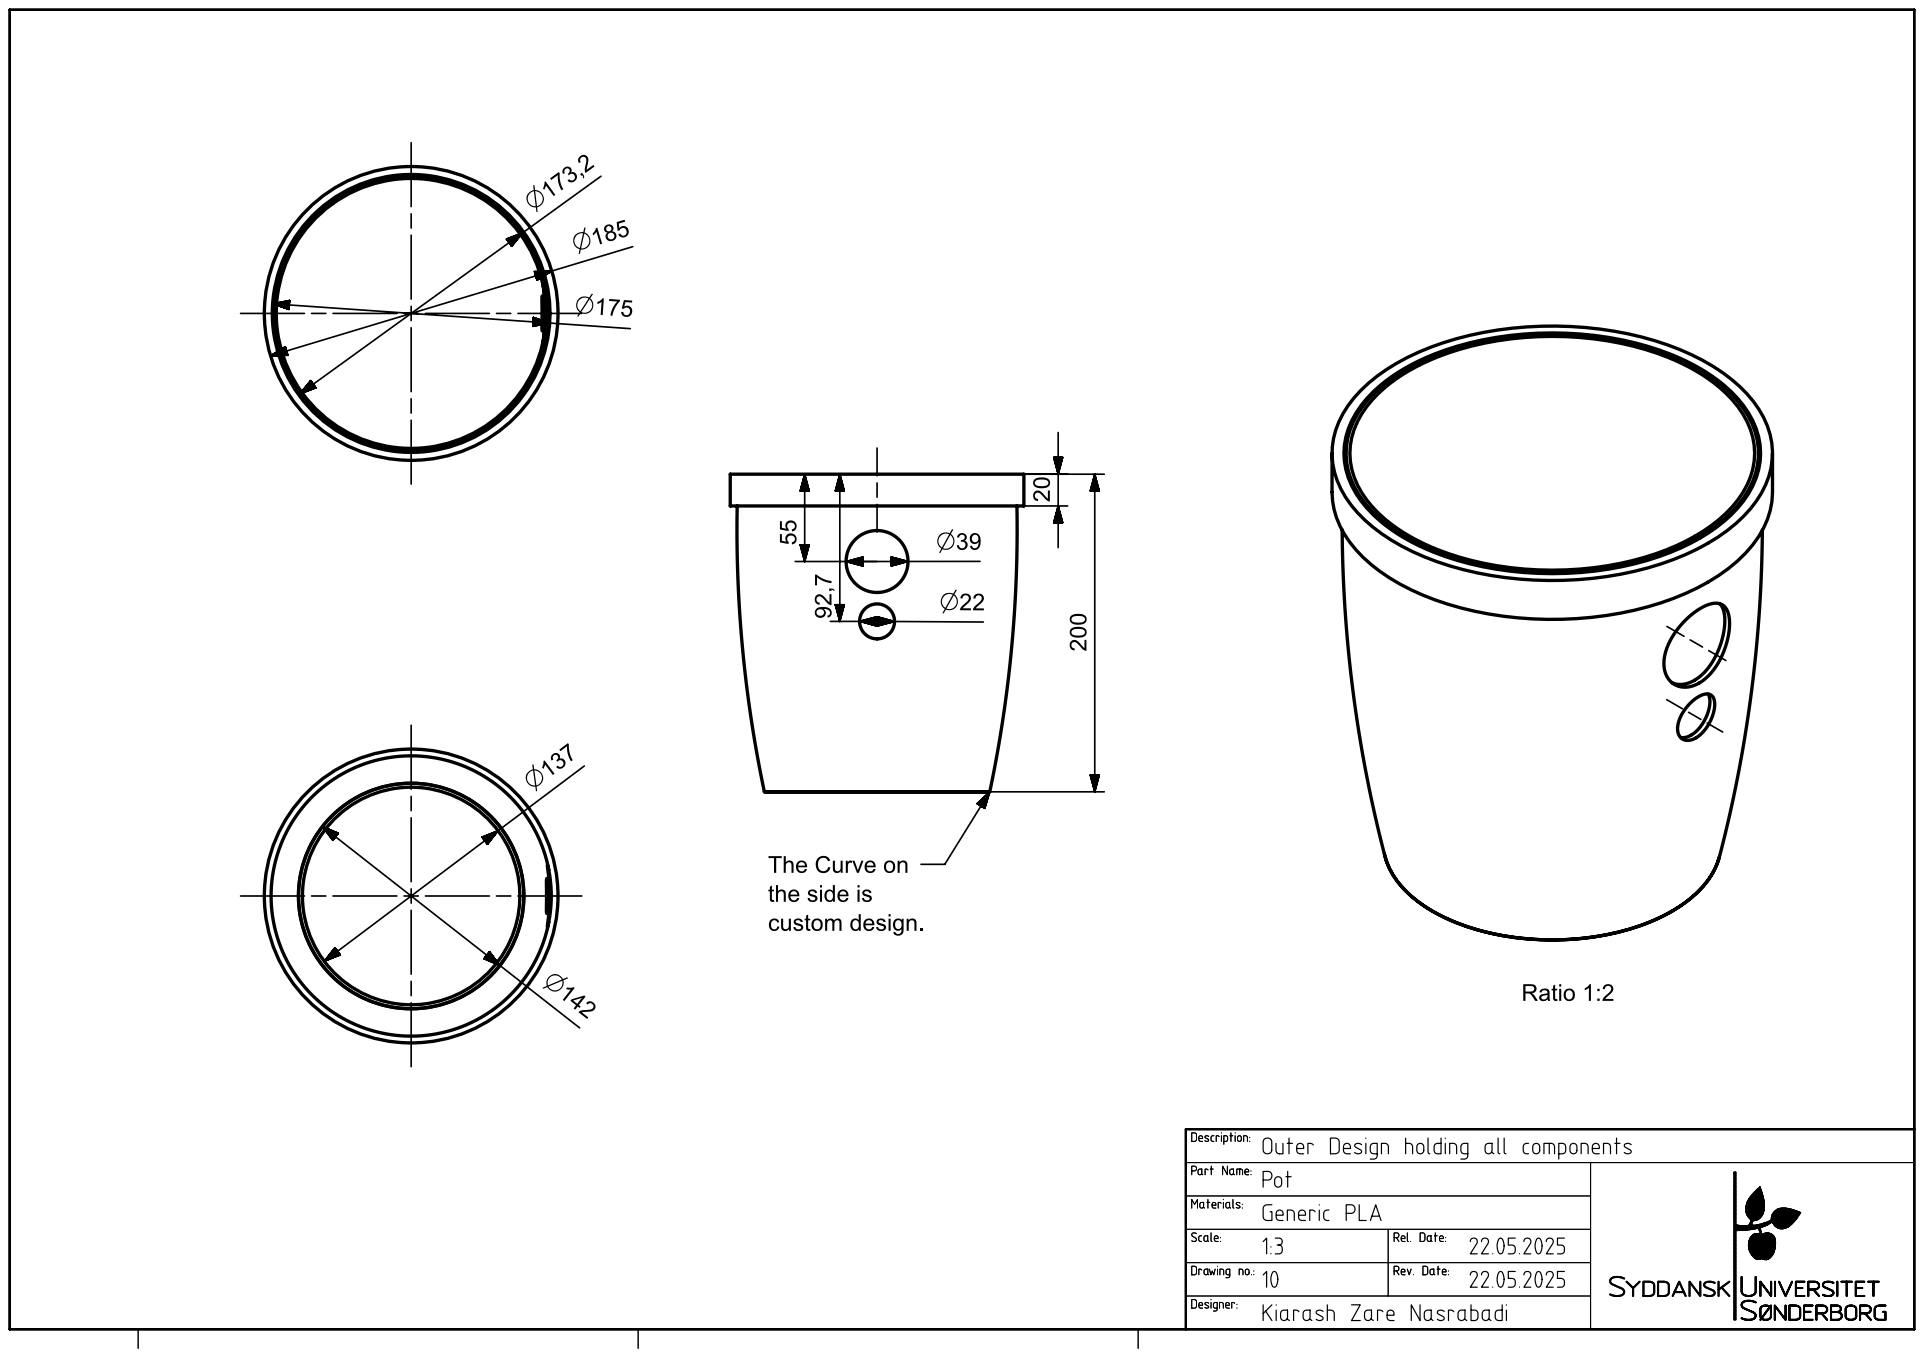
[picture p98: page 1]
