kia-8/SPRO2_S.O.B/Mechanical/Technical Drawing/kiarash_Pulleys.pdf

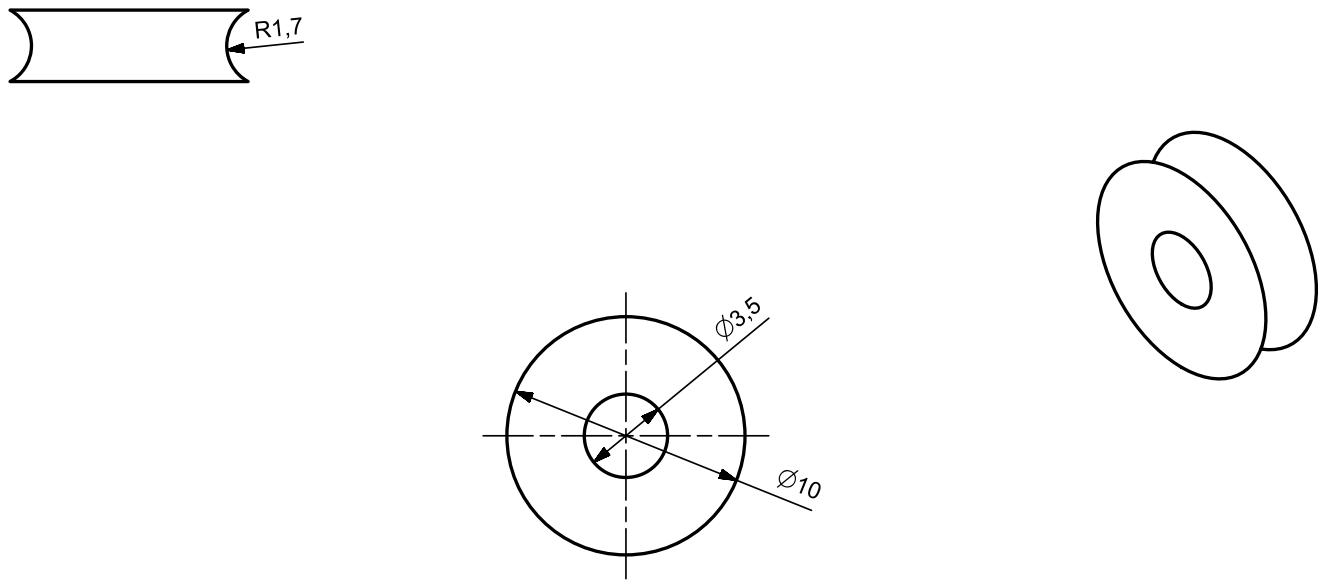
[picture p99: page 1]
