kia-8/SPRO2_S.O.B/Mechanical/Technical Drawing/kiarash_Servo motor holder.pdf

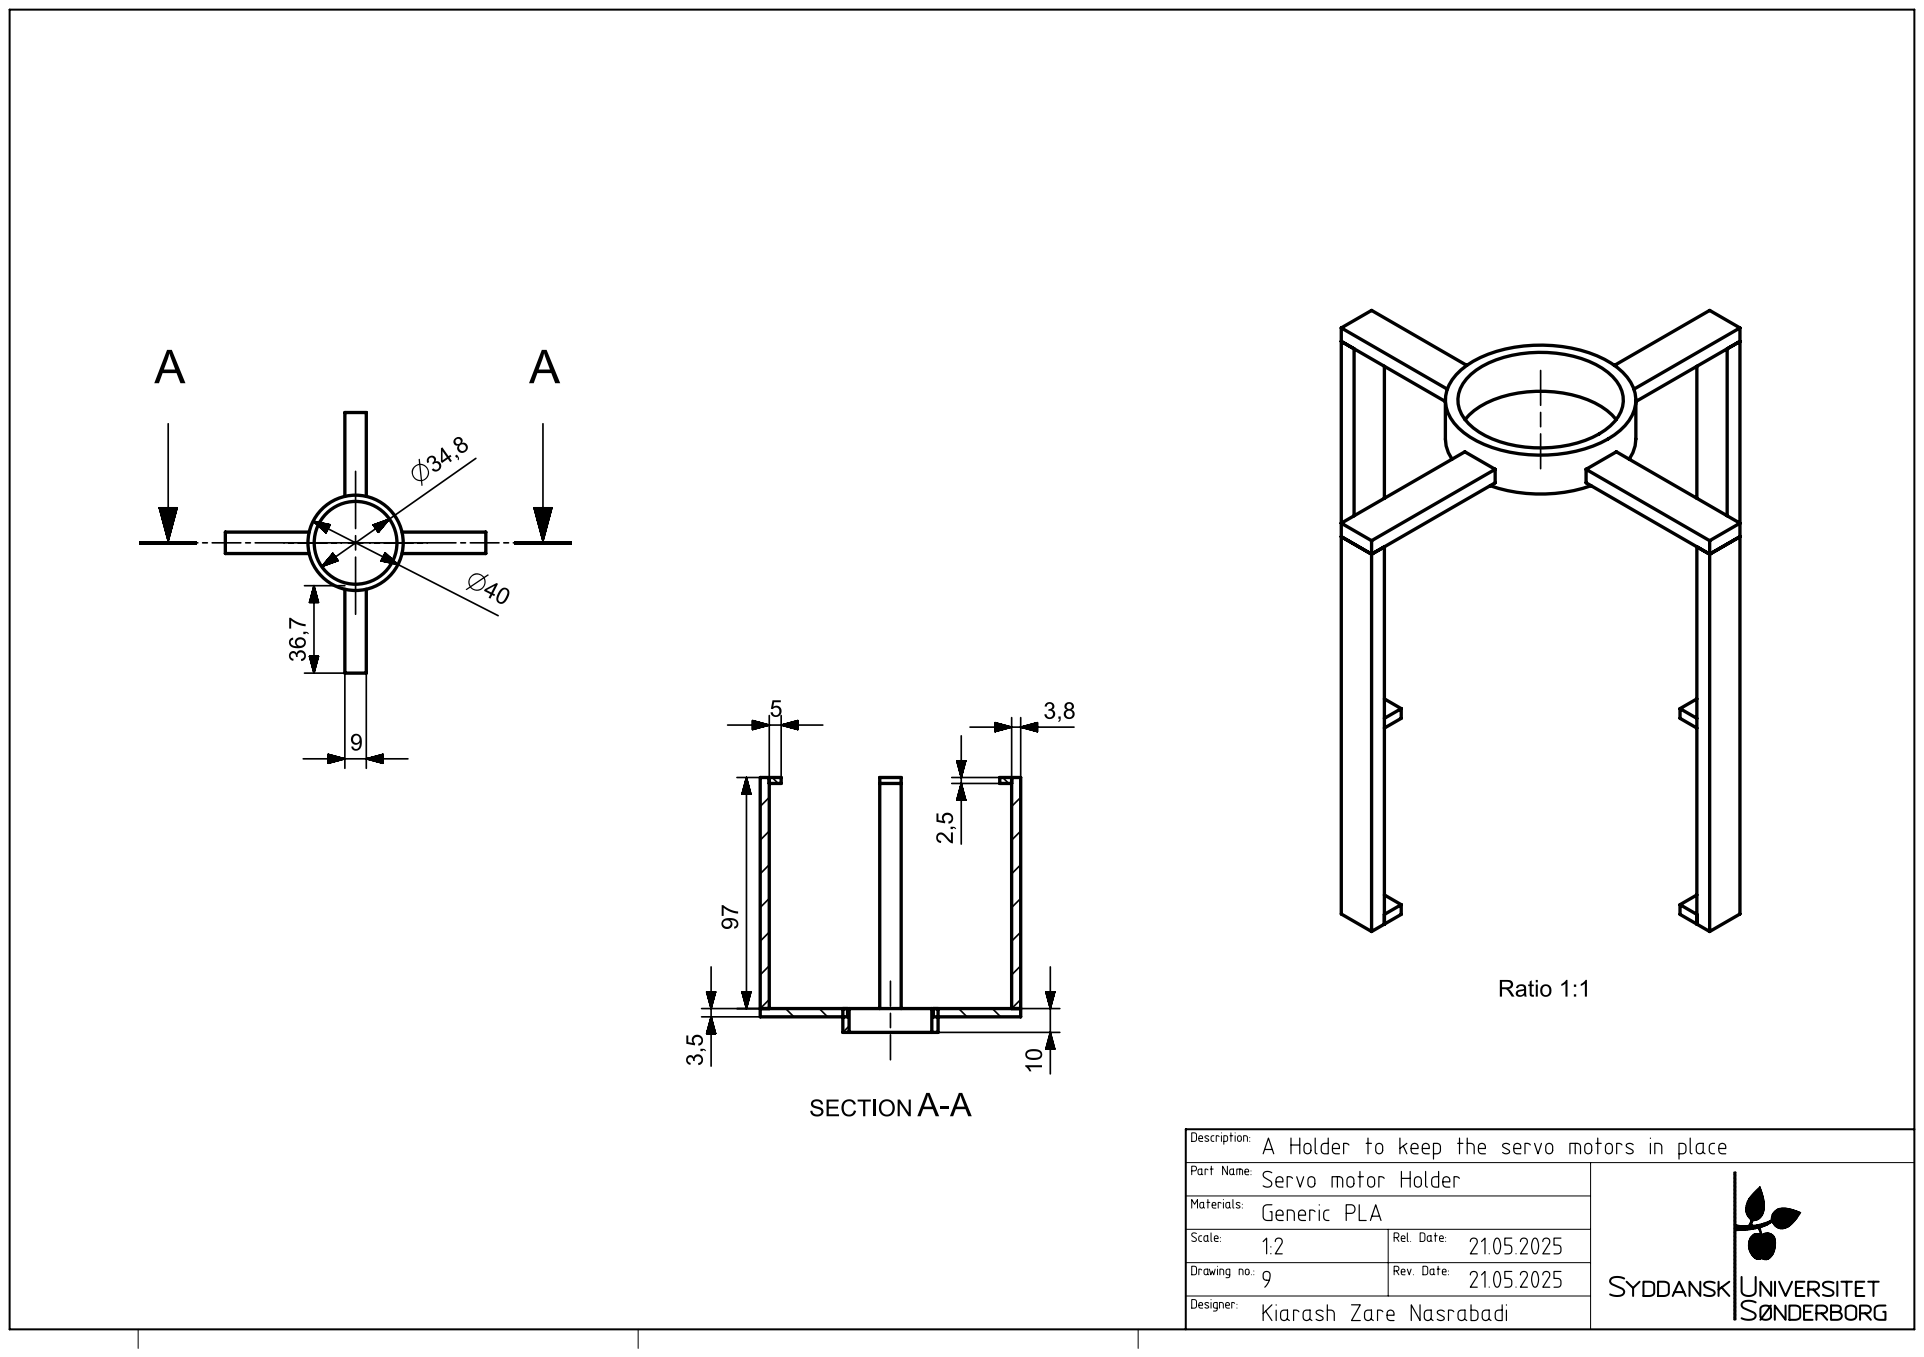
[picture p100: page 1]
