kia-8/SPRO2_S.O.B/Mechanical/Technical Drawing/kiarash_shaft.pdf

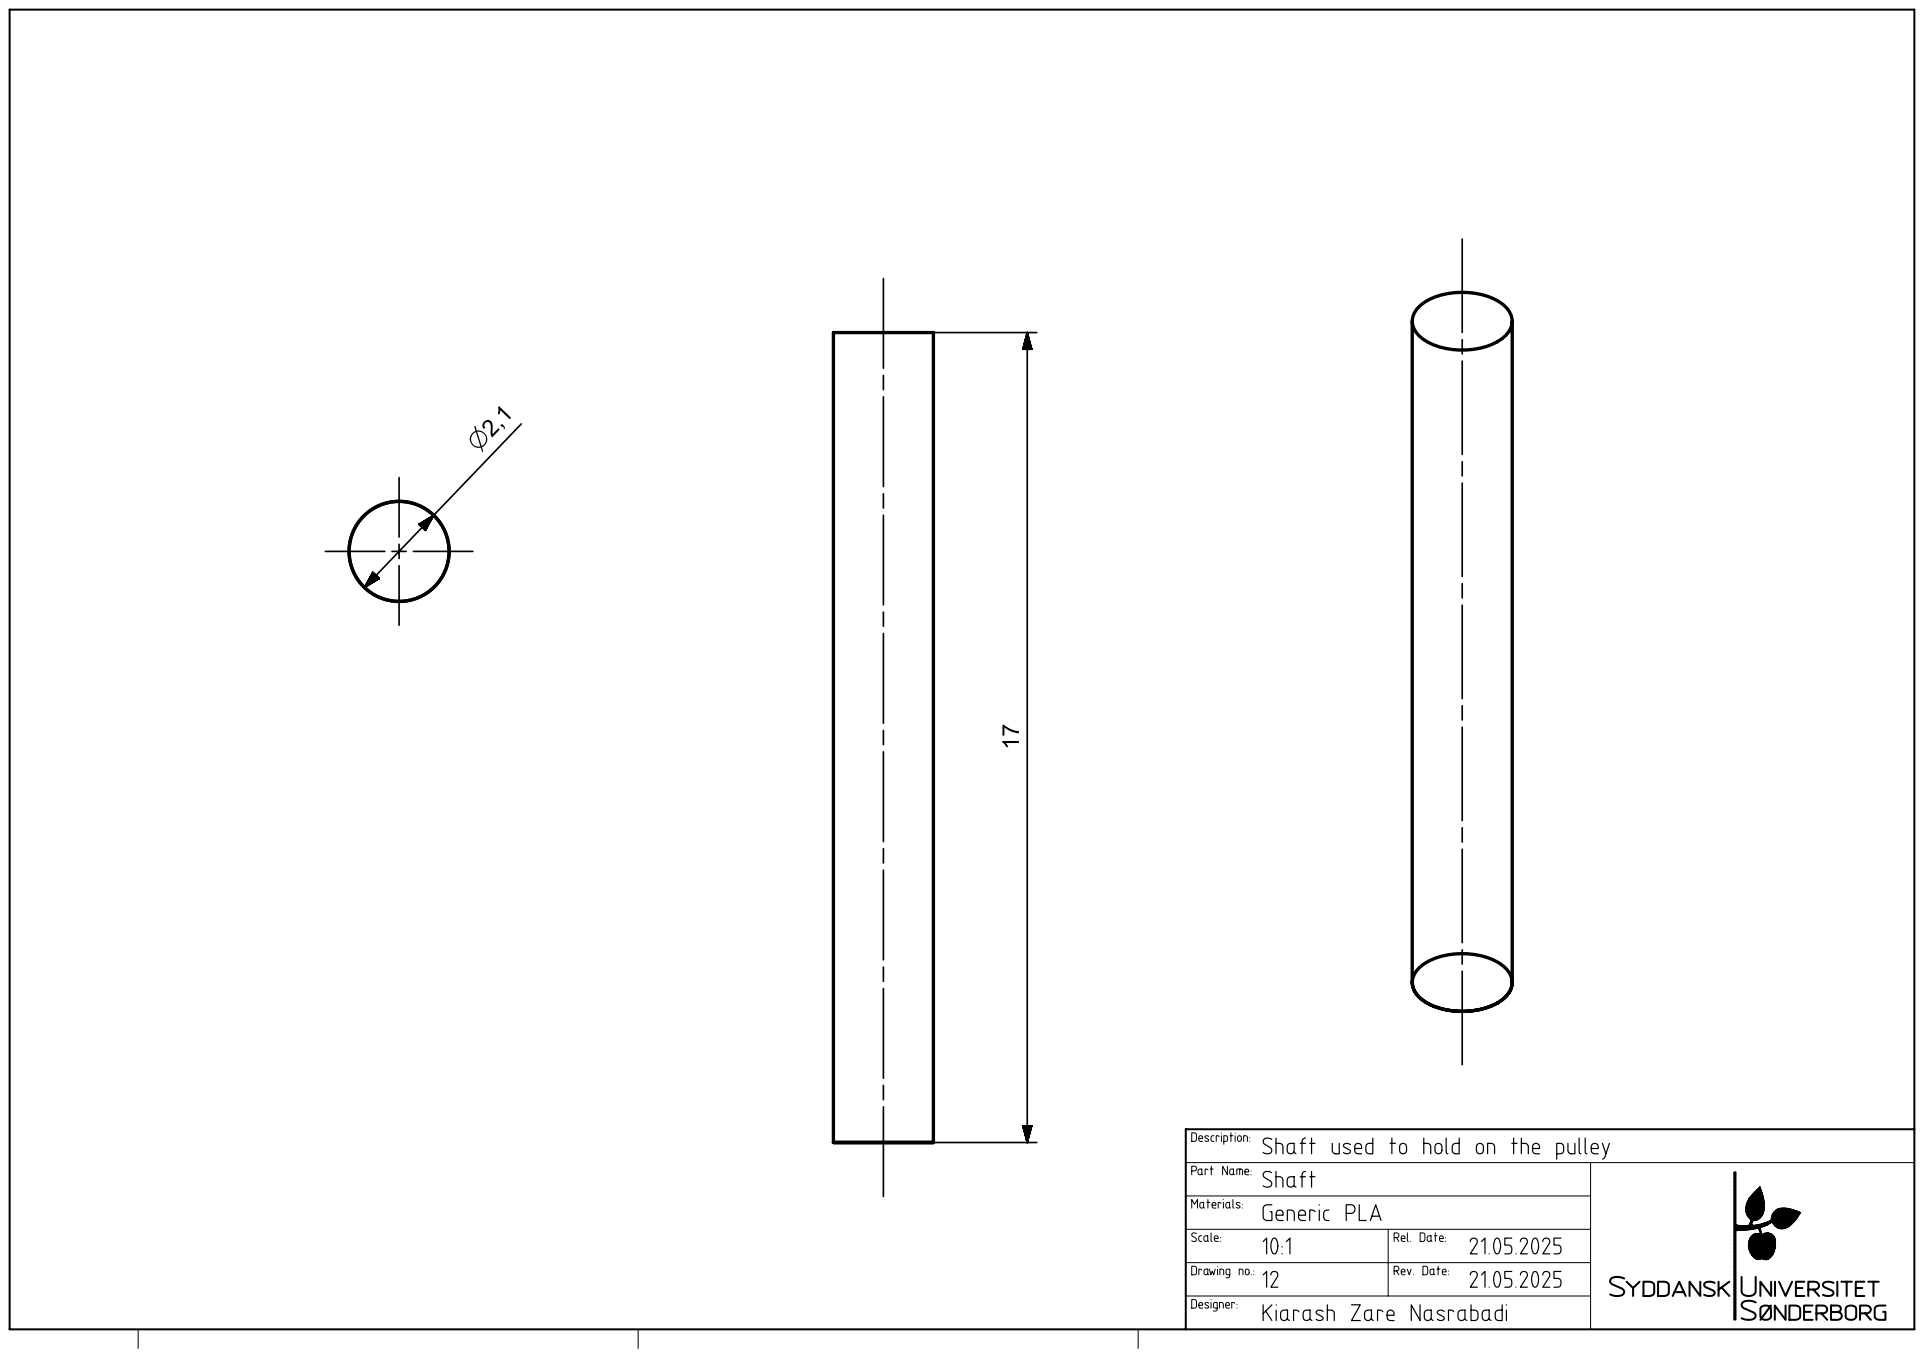
[picture p101: page 1]
