kia-8/SPRO2_S.O.B/Mechanical/Technical Drawing/kiarash_Solar_arm_LDR_2.pdf

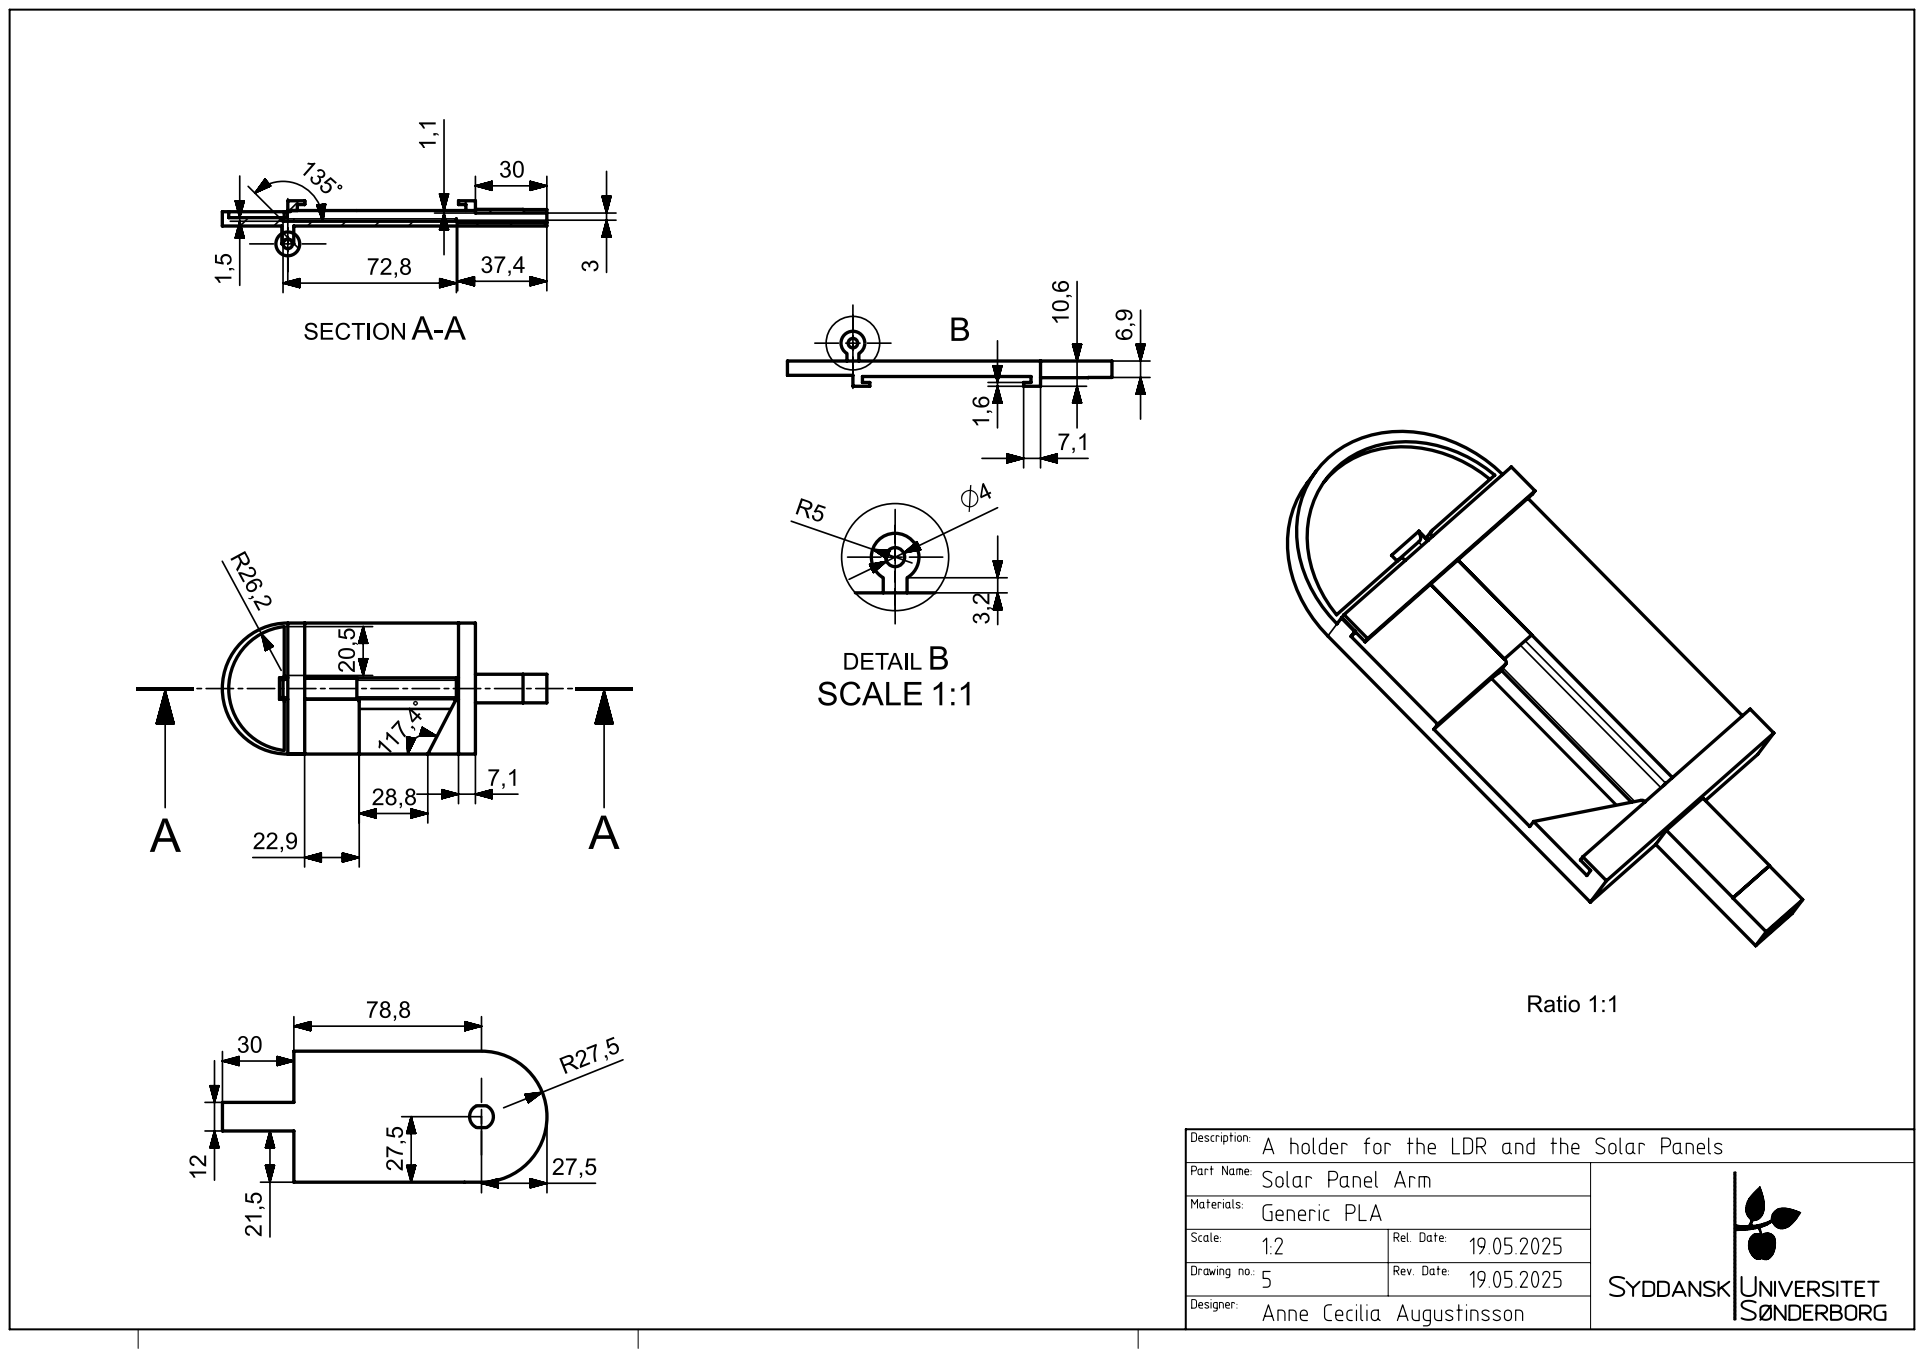
[picture p102: page 1]
