kia-8/SPRO2_S.O.B/Mechanical/Technical Drawing/kiarash_Solar_midt_dims final.pdf

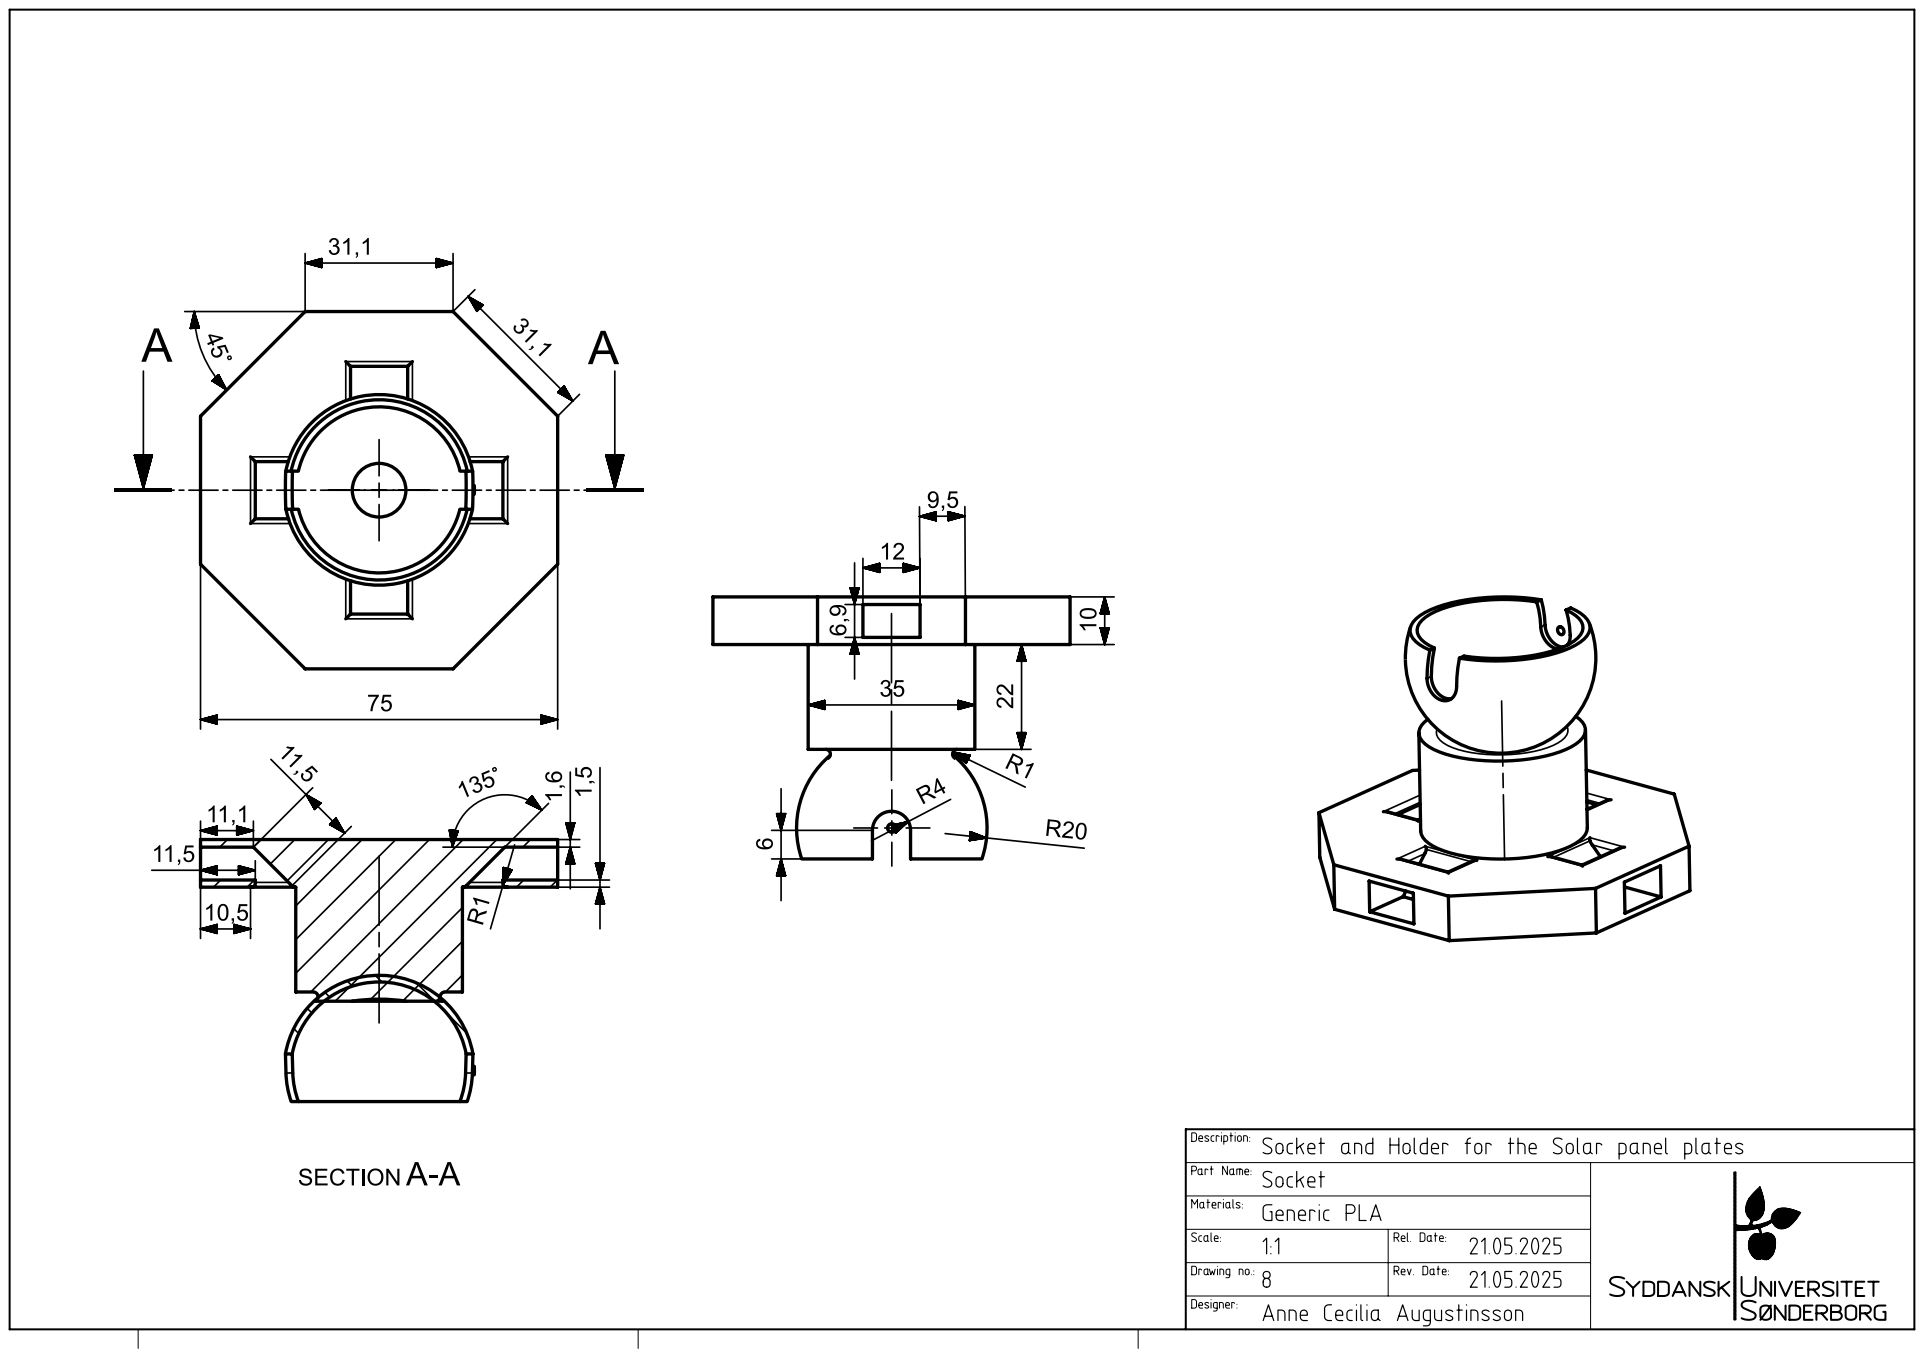
[picture p103: page 1]
