kia-8/SPRO2_S.O.B/Mechanical/Technical Drawing/kiarash_spl2.pdf

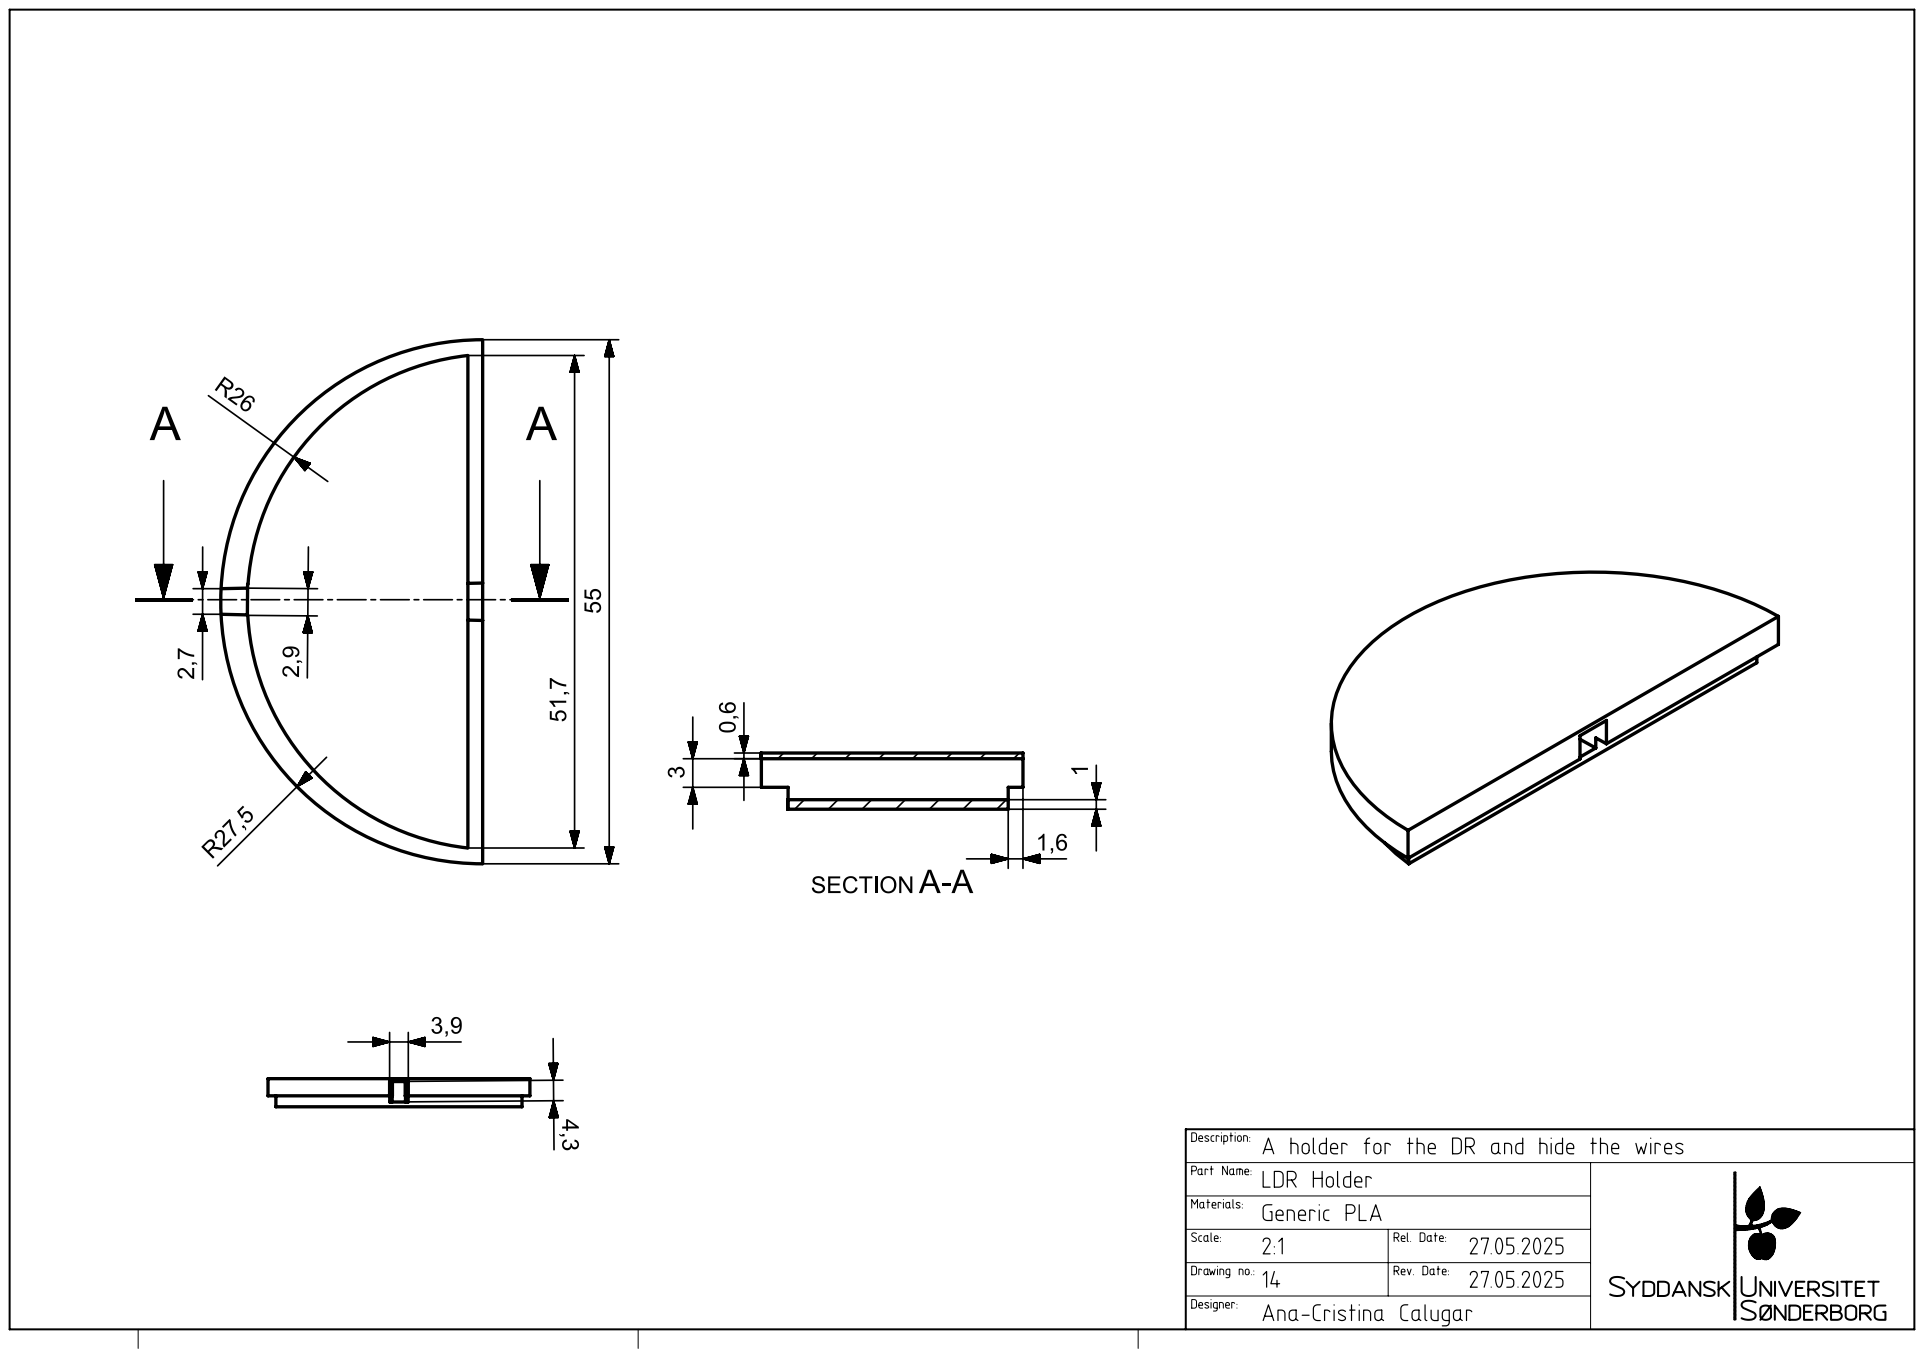
[picture p104: page 1]
