kia-8/SPRO2_S.O.B/Mechanical/Technical Drawing/kiarash_Stem SOB final lower.pdf

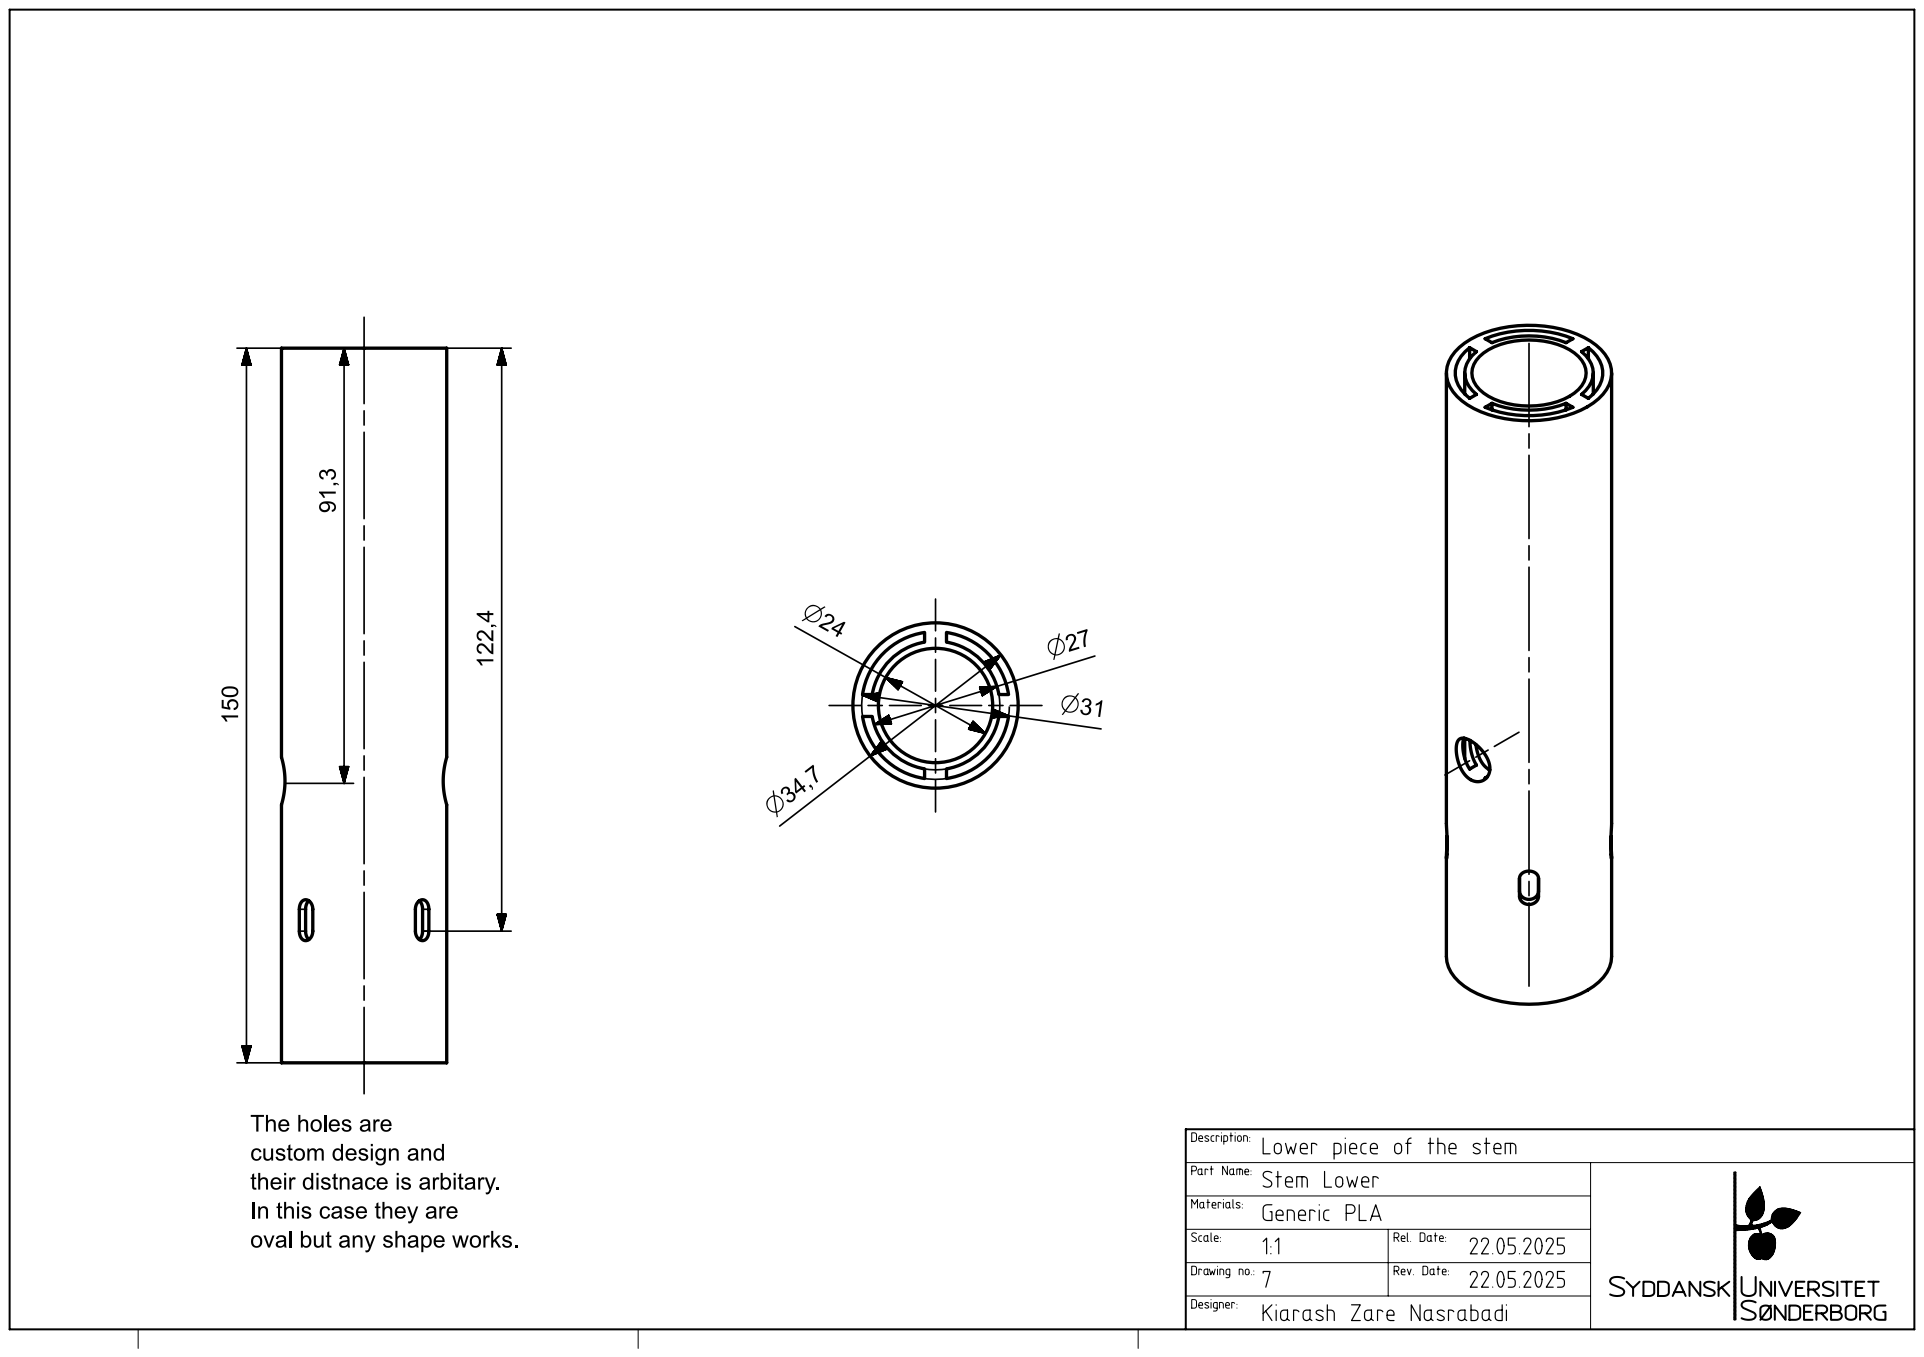
[picture p105: page 1]
