kia-8/SPRO2_S.O.B/Mechanical/Technical Drawing/kiarash_Stem SOB final.pdf

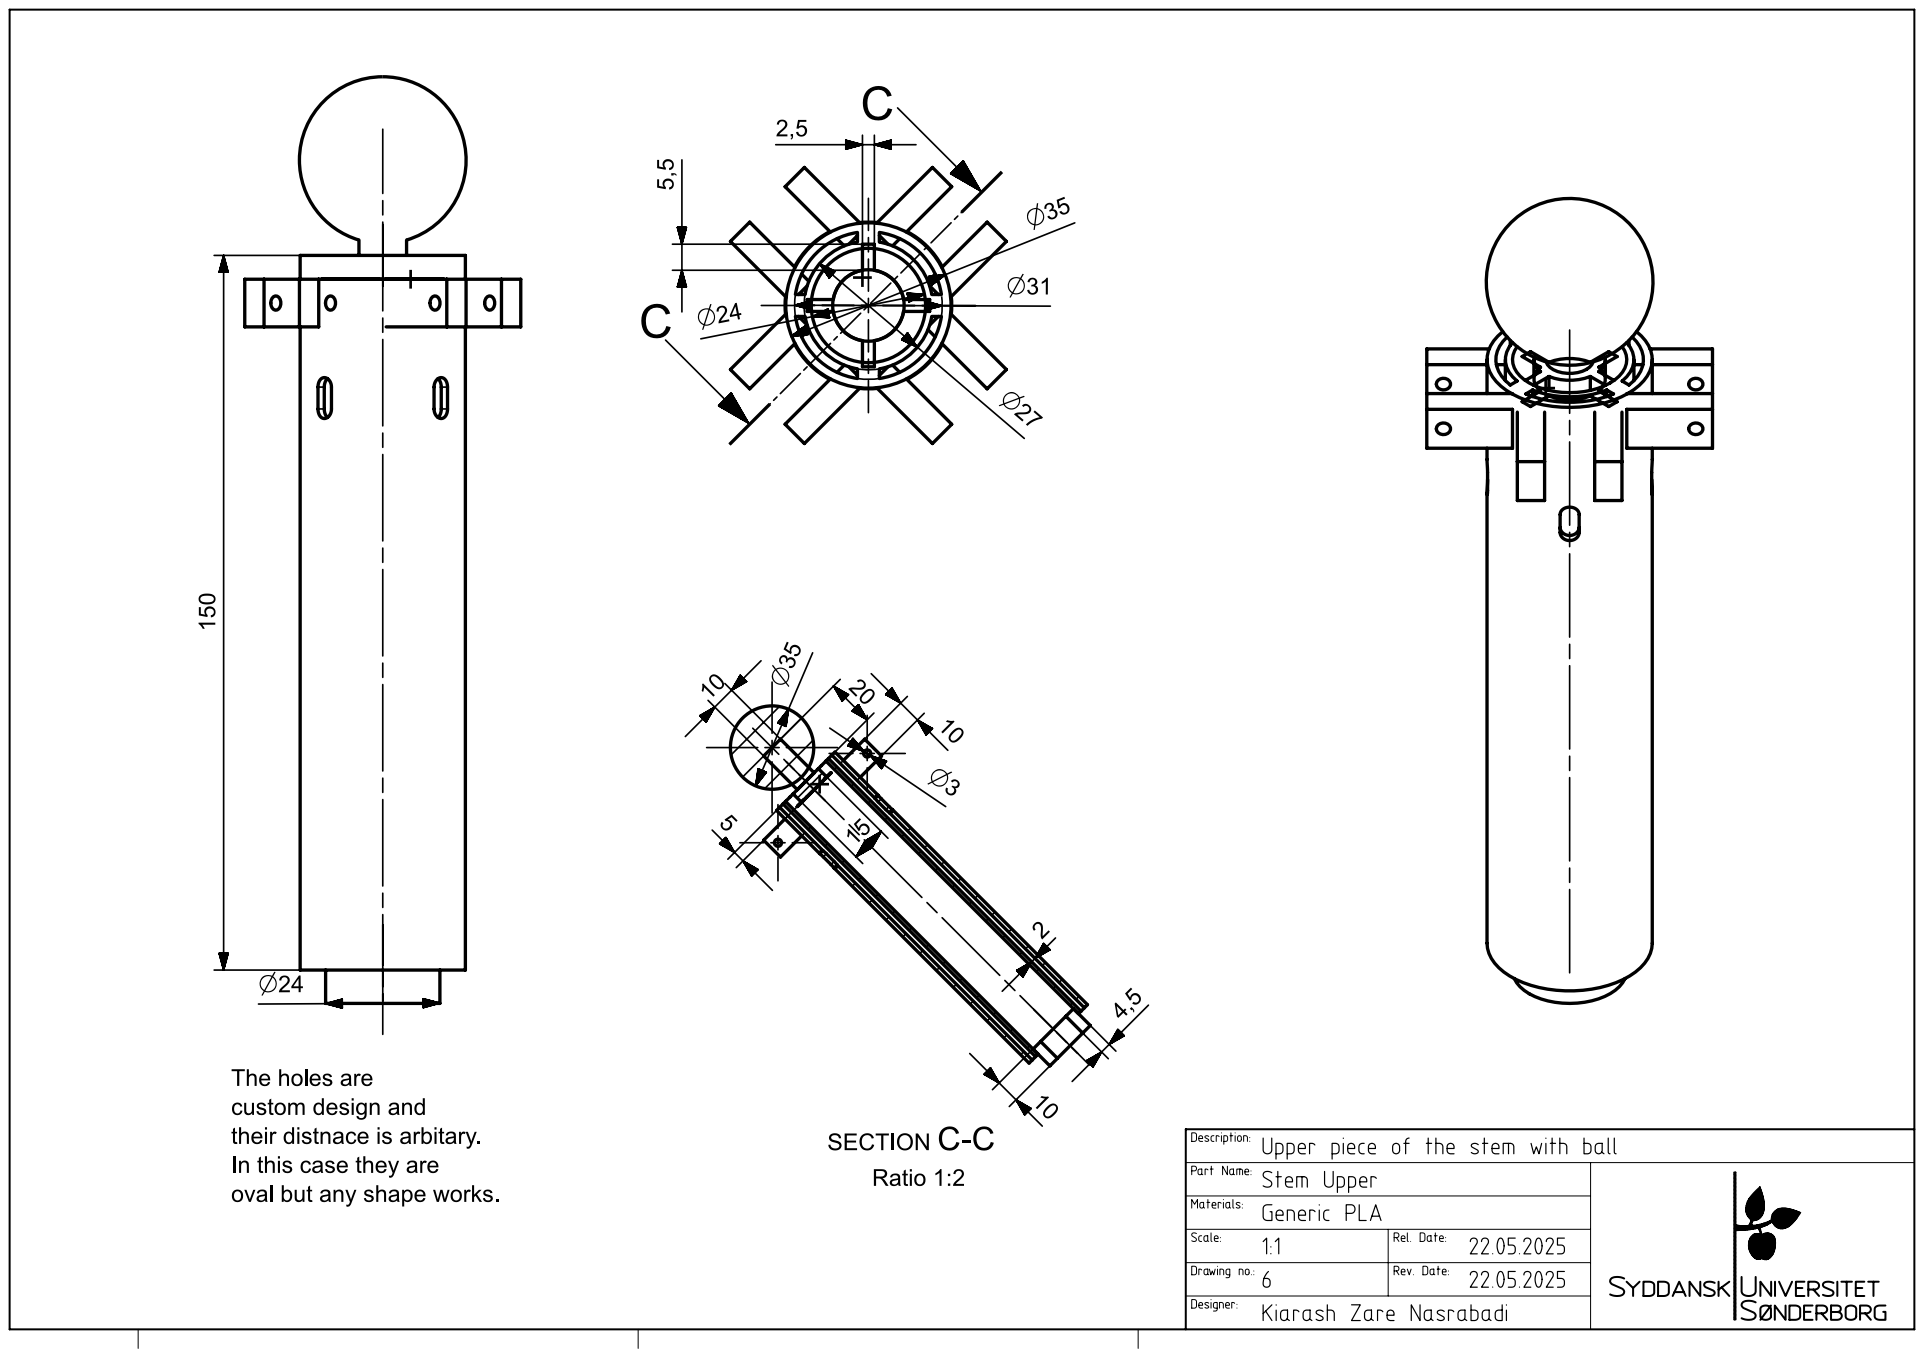
[picture p106: page 1]
