kia-8/SPRO2_S.O.B/(list of files, cad)

Other CAD files:
Mechanical/NX Design/Arduino final.prt
Mechanical/NX Design/Arduino.prt
Mechanical/NX Design/Assembly SOB final.prt
Mechanical/NX Design/Battery holder.prt
Mechanical/NX Design/Case Box.prt
Mechanical/NX Design/Case of Servo.prt
Mechanical/NX Design/Case top part 3.prt
Mechanical/NX Design/Case top part2.prt
Mechanical/NX Design/Floor 1.prt
Mechanical/NX Design/Floor 2.prt
Mechanical/NX Design/Gear potentiometer.prt
Mechanical/NX Design/LDR Holder.prt
Mechanical/NX Design/Motor Driver case.prt
Mechanical/NX Design/Motor Driver plate.prt
Mechanical/NX Design/Motor gear final.prt
Mechanical/NX Design/Pot.prt
Mechanical/NX Design/Pulleys.prt
Mechanical/NX Design/Servo Gear0.prt
Mechanical/NX Design/Servo Gear1.prt
Mechanical/NX Design/Servo Gear2.prt
Mechanical/NX Design/Servo motor Bottom.prt
Mechanical/NX Design/Servo motor Top.prt
Mechanical/NX Design/Servo motor holder.prt
Mechanical/NX Design/Servo motor.prt
Mechanical/NX Design/Sliding Top.prt
Mechanical/NX Design/Socket.prt
Mechanical/NX Design/Solar Panel Arm.prt
Mechanical/NX Design/Solar_midt_dims.prt
Mechanical/NX Design/Stem SOB final.prt
Mechanical/NX Design/shaft.prt
